therickmatos/Seguidor-de-linha/referencias/README.md

# Referências

## eva-rt/
Cópia do repositório [EXOTIC-TEAM-MX/EVA-RT](https://github.com/EXOTIC-TEAM-MX/EVA-RT) (commit `d630829`), sem a pasta `images/` (fotos grandes).
© EXOTIC TEAM MX, licença AGPL-3.0 (`eva-rt/LICENSE`).

- `3d_models/` — STL (carcaça e rotor da ventoinha, base de sucção, caixas de redução, aro, presilha, patim, suportes da bateria).
- `pcb_files/` — projeto EasyEDA Pro (`EVA_RT.eprj`, abre direto no EasyEDA Pro: footprints, posições e roteamento originais), Gerbers da placa principal e da barra VISION, PDFs de esquemático e PCB.
- `source_code/` — firmware 1.2.2 e LITE 1.0.
