therickmatos/Seguidor-de-linha/docs/DECISOES_2026-11-04.md

# Decisões de 03–04/11/2026 (depois do esquemático)

_Complementa `SEGUIDOR_JLC_DECISOES.md` e `ESQUEMATICO_SEGUIDOR.md`. Origem = centro da ventoinha, +y = frente, mm._

## Esquemático
- Feito em KiCad (rev 1.0), com todas as trocas: `hardware/seguidor_base/` (PDF, projeto, BOM, `REDES.md`).
- Conectividade conferida contra a netlist exportada: 54 redes, nenhuma fusão indevida, 7 pinos sem uso marcados.
- Gerado por script (`ferramentas/esquematico/gen.py`); footprints ainda não atribuídos (etapa da PCB).

## STL do EVA-RT × placa
- **Ordem: placa primeiro.** Os STL do EVA-RT são a referência fixa; a placa se ajusta a eles. A impressão leva horas; a placa, semanas.
- **Sem mudança:** gearbox, wheel_rim (692ZZ cabe), impeller_base_1/2, impeller_fan, suction_base, bead, battery_holder, barilla_clamp/barilla_connection. O contorno B mantém o furo Ø17 da ventoinha, os 4 furos da carcaça em (±15,56; ±15,56), os 4 dos suportes de motor em (±35,25; −3,73/−26,55) e as presilhas da vareta em (±43,75; −1,75/10,75).
- **Patim da barra:** usar o `sensor_sledge` refeito na v5 para os furos Ø2,05 da V1 (x = ±44,63, 89,25 mm entre furos; na VISION são ±44,0). Os furos Ø1,6 sem metalização em (±9,2; 0,55) são iguais na V1 e na VISION.
- **Distância barra–eixo L = 67–70 mm:** só cortar a vareta (~44 mm, uns 12 mm mais curta que a do EVA-RT).
- **Áreas proibidas no layout:**
  - embaixo: placa de sucção, x ±23,1, y −27,5…21;
  - em cima: pés da carcaça da ventoinha (impeller_base_1);
  - furos e caminho das presilhas da vareta.
- **Antes de pedir:** exportar o 3D da placa e montar com os STL para conferir colisões.
- Talvez rever o battery_holder depois de posicionar o conector de gravação (a bateria apoia ~2,5 mm nele).

## Barra de sensores
- **Fica a V1 de 12 sensores** (geometria da VISION do EVA-RT, firmware 1.2.2 como está). Erick já tem as barras; não entra no pedido.
- 16 sensores: só numa V2 futura, no mesmo conector. O firmware é parametrizado (`NUM_SENSORS`, `FIRST/LAST_SENSOR_SWITCH_CONFIG`); o `ADC_GND_CHANNEL` é o canal GND interno do ATmega, não do mux. Reajustar KP/KD.
- Corrente dos LEDs da barra: 2 QRE em série por 150 Ω (~17 mA por par) → ~104 mA com 12 sensores.

## Pedido JLC (cupom de US$ 50)
- Duas placas: **seguidor com os braços de marca integrados** + **perseguidor**.
- Terceira vaga: não precisa ocupar. Avaliado:
  - v5 de fenolite como plano B do seguidor: reduz risco de erro de projeto, mas tem 148 × 78 mm (passa de 100 × 100), ainda não está no EasyEDA e não protege contra atraso do frete;
  - placa de outro robô: agora não (rouba tempo do layout);
  - saldo para frete/imposto ou estêncil (só se soldar com pasta + ar quente/placa aquecedora; pesa no frete).
- **PCBA só pela cor preta não compensa:** a PCB sai em 24 h, mas a montagem SMT vem depois (24–48 h) e o valor declarado sobe. Se fizer PCBA, que seja dos dois DRV8874 (pad térmico).

## Nome do seguidor (não decidido)
- Favoritos: **AVE** (EVA ao contrário; "AVE · baseado no EVA-RT") e **SACI** (redemoinho = ventoinha centrífuga).
- Outros: ÍRIS, NOVA, CORISCO, SUCURI, COLIBRI, RISCO, FAÍSCA, VÁCUO, VEGA, KIDDO, 88, AUTOBAHN.
- Conferir se nenhuma equipe do TRIF/RoboCore já usa.

## Próximos passos
1. Layout da placa base no EasyEDA Pro: contorno B (`hardware/contorno/`), esquemático KiCad como referência, áreas dos STL, DRV8874 com vias no pad térmico.
2. Placa do perseguidor.
3. 3D da placa × STL; Gerber; pedido na JLC.
4. Firmware EVA-RT 1.2.2 (mapa de pinos igual).

## Fora deste pacote
- `EVA-RT_B_degraus_referencia.dxf` e `marcas_sim.py` (feitos em outra conversa).
- Arquivos da fenolite v3/v4/v5 (repositório `therickmatos/seguidor-fenolite`).
