therickmatos/Seguidor-de-linha/Estudo de caso - viabilidade do seguidor de linha/08_chassi_asa_de_gaivota/dados/tabelas.md

# Tabelas geradas por `codigo/verificar.py`

Margem = quanto o centro do QRE entra na fita, na pior marca (mm; negativo = não passa). "Comum" = mesma conta na região que vale para qualquer fita dentro da tolerância do regulamento (±1 mm na linha, ±3 mm na marca).

## TRIF 2025

| Configuração | Cenário | Marcas (esq. / dir.) | Região comum | Margem mín. | Margem comum | Pior marca | Folga até a linha (int. / ext.) |
|---|---|---:|---:|---:|---:|---|---|
| Asa de gaivota · 63,14 mm | ideal | 33/33 (31/31 · 2/2) | 33/33 | 5.5 | 0.9 | C30 | 1.9 / 32.8 |
| Asa de gaivota · 63,14 mm | desvio -3 mm | 33/33 (31/31 · 2/2) | 33/33 | 5.0 | 0.5 | Partida | 5.5 / 36.4 |
| Asa de gaivota · 63,14 mm | desvio +3 mm | 33/33 (31/31 · 2/2) | 30/33 | 3.2 | -2.0 | C06 | -1.7 / 29.2 |
| Asa de gaivota · 63,14 mm | desvio -5 mm | 33/33 (31/31 · 2/2) | 33/33 | 3.6 | 0.6 | C14 | 3.5 / 34.5 |
| Asa de gaivota · 63,14 mm | desvio +5 mm | 33/33 (31/31 · 2/2) | 30/33 | 1.4 | -3.8 | C06 | -4.1 / 26.8 |
| Asa de gaivota · 63,14 mm | abre 10 mm | 33/33 (31/31 · 2/2) | 33/33 | 5.5 | 0.4 | C25 | 8.6 / 39.5 |
| Asa de gaivota · 63,14 mm | abre 20 mm | 33/33 (31/31 · 2/2) | 33/33 | 5.6 | 0.7 | C07 | 15.3 / 46.2 |
| Asa de gaivota · 63,14 mm | abre 30 mm | 33/33 (31/31 · 2/2) | 33/33 | 5.6 | 0.4 | C13 | 21.2 / 52.3 |
| Asa de gaivota · 65 mm | ideal | 33/33 (31/31 · 2/2) | 32/33 | 5.1 | -0.1 | C06 | 0.7 / 31.6 |
| Asa de gaivota · 65 mm | desvio -3 mm | 33/33 (31/31 · 2/2) | 33/33 | 4.9 | 0.5 | C14 | 4.3 / 35.2 |
| Asa de gaivota · 65 mm | desvio +3 mm | 33/33 (31/31 · 2/2) | 30/33 | 2.3 | -2.9 | C06 | -2.9 / 28.0 |
| Asa de gaivota · 65 mm | desvio -5 mm | 33/33 (31/31 · 2/2) | 33/33 | 3.0 | -0.0 | C14 | 2.5 / 33.5 |
| Asa de gaivota · 65 mm | desvio +5 mm | 33/33 (31/31 · 2/2) | 30/33 | 0.4 | -4.8 | C06 | -5.3 / 25.6 |
| Asa de gaivota · 65 mm | abre 10 mm | 33/33 (31/31 · 2/2) | 33/33 | 5.4 | 0.3 | C01 | 7.3 / 38.2 |
| Asa de gaivota · 65 mm | abre 20 mm | 33/33 (31/31 · 2/2) | 33/33 | 5.8 | 0.8 | C07 | 14.0 / 44.9 |
| Asa de gaivota · 65 mm | abre 30 mm | 33/33 (31/31 · 2/2) | 33/33 | 5.6 | 0.6 | C13 | 20.2 / 51.2 |
| Asa de gaivota · 61 mm (referência) | ideal | 33/33 (31/31 · 2/2) | 33/33 | 5.4 | 0.9 | C03 | 3.3 / 34.2 |
| Asa de gaivota · 61 mm (referência) | desvio -3 mm | 33/33 (31/31 · 2/2) | 33/33 | 5.0 | 0.5 | Partida | 6.9 / 37.7 |
| Asa de gaivota · 61 mm (referência) | desvio +3 mm | 33/33 (31/31 · 2/2) | 30/33 | 4.4 | -0.9 | C06 | -0.3 / 30.6 |
| Asa de gaivota · 61 mm (referência) | desvio -5 mm | 33/33 (31/31 · 2/2) | 33/33 | 4.4 | 1.4 | C14 | 4.6 / 35.6 |
| Asa de gaivota · 61 mm (referência) | desvio +5 mm | 33/33 (31/31 · 2/2) | 30/33 | 2.5 | -2.7 | C06 | -2.7 / 28.1 |
| Asa de gaivota · 61 mm (referência) | abre 10 mm | 33/33 (31/31 · 2/2) | 33/33 | 5.2 | 0.5 | C25 | 10.0 / 40.9 |
| Asa de gaivota · 61 mm (referência) | abre 20 mm | 33/33 (31/31 · 2/2) | 33/33 | 5.8 | 0.7 | C05 | 16.7 / 47.6 |
| Asa de gaivota · 61 mm (referência) | abre 30 mm | 33/33 (31/31 · 2/2) | 33/33 | 5.6 | 0.5 | C13 | 22.4 / 53.5 |
| Asa anterior, externo (82; 20) · 63,14 mm | ideal | 33/33 (31/31 · 2/2) | 33/33 | 5.2 | 0.9 | C30 | 1.9 / 34.0 |
| Asa anterior, externo (82; 20) · 63,14 mm | desvio -3 mm | 33/33 (31/31 · 2/2) | 33/33 | 4.5 | 0.5 | Partida | 5.5 / 37.6 |
| Asa anterior, externo (82; 20) · 63,14 mm | desvio +3 mm | 33/33 (31/31 · 2/2) | 30/33 | 3.2 | -2.0 | C06 | -1.7 / 30.4 |
| Asa anterior, externo (82; 20) · 63,14 mm | desvio -5 mm | 33/33 (31/31 · 2/2) | 33/33 | 4.4 | 1.1 | C14 | 3.5 / 35.6 |
| Asa anterior, externo (82; 20) · 63,14 mm | desvio +5 mm | 33/33 (31/31 · 2/2) | 30/33 | 1.4 | -3.8 | C06 | -4.1 / 27.9 |
| Asa anterior, externo (82; 20) · 63,14 mm | abre 10 mm | 33/33 (31/31 · 2/2) | 33/33 | 5.5 | 0.1 | C01 | 8.6 / 40.7 |
| Asa anterior, externo (82; 20) · 63,14 mm | abre 20 mm | 33/33 (31/31 · 2/2) | 33/33 | 5.6 | 0.5 | C13 | 15.3 / 47.3 |
| Asa anterior, externo (82; 20) · 63,14 mm | abre 30 mm | 33/33 (31/31 · 2/2) | 33/33 | 5.3 | 0.4 | C10 | 21.2 / 53.2 |
| Chassi baixo (esboço) · 63,14 mm | ideal | 33/33 (31/31 · 2/2) | 33/33 | 5.4 | 1.6 | C14 | 4.8 / 29.8 |
| Chassi baixo (esboço) · 63,14 mm | desvio -3 mm | 33/33 (31/31 · 2/2) | 32/33 | 2.7 | -0.4 | C14 | 8.4 / 33.4 |
| Chassi baixo (esboço) · 63,14 mm | desvio +3 mm | 33/33 (31/31 · 2/2) | 30/33 | 4.3 | -1.3 | C06 | 1.2 / 26.2 |
| Chassi baixo (esboço) · 63,14 mm | desvio -5 mm | 33/33 (31/31 · 2/2) | 32/33 | 0.8 | -2.2 | C14 | 6.2 / 31.4 |
| Chassi baixo (esboço) · 63,14 mm | desvio +5 mm | 33/33 (31/31 · 2/2) | 30/33 | 2.4 | -3.2 | C06 | -1.2 / 23.8 |
| Chassi baixo (esboço) · 63,14 mm | abre 10 mm | 33/33 (31/31 · 2/2) | 33/33 | 7.9 | 3.4 | C17 | 11.5 / 36.5 |
| Chassi baixo (esboço) · 63,14 mm | abre 20 mm | 33/33 (31/31 · 2/2) | 33/33 | 8.9 | 3.6 | C31 | 18.1 / 43.1 |
| Chassi baixo (esboço) · 63,14 mm | abre 30 mm | 33/33 (31/31 · 2/2) | 33/33 | 7.6 | 3.3 | C13 | 23.6 / 49.0 |
| v3 atual · 63,14 mm | ideal | 24/33 (22/31 · 2/2) | 16/33 | -10.9 | -16.0 | C06 | 19.3 |
| v3 atual · 63,14 mm | desvio -3 mm | 24/33 (22/31 · 2/2) | 21/33 | -8.1 | -13.2 | C06 | 22.9 |
| v3 atual · 63,14 mm | desvio +3 mm | 22/33 (20/31 · 2/2) | 15/33 | -13.7 | -18.8 | C06 | 15.7 |
| v3 atual · 63,14 mm | desvio -5 mm | 27/33 (25/31 · 2/2) | 22/33 | -7.2 | -11.4 | C14 | 21.3 |
| v3 atual · 63,14 mm | desvio +5 mm | 19/33 (17/31 · 2/2) | 15/33 | -15.6 | -20.7 | C06 | 13.3 |
| v3 atual · 63,14 mm | abre 10 mm | 28/33 (26/31 · 2/2) | 21/33 | -6.7 | -12.0 | C06 | 26.0 |
| v3 atual · 63,14 mm | abre 20 mm | 33/33 (31/31 · 2/2) | 24/33 | 1.4 | -4.4 | C08 | 32.7 |
| v3 atual · 63,14 mm | abre 30 mm | 33/33 (31/31 · 2/2) | 31/33 | 3.0 | -2.2 | C08 | 39.5 |

## TRIF 2024

| Configuração | Cenário | Marcas (esq. / dir.) | Região comum | Margem mín. | Margem comum | Pior marca | Folga até a linha (int. / ext.) |
|---|---|---:|---:|---:|---:|---|---|
| Asa de gaivota · 63,14 mm | ideal | 35/35 (33/33 · 2/2) | 35/35 | 5.9 | 1.2 | C27 | 3.5 / 34.3 |
| Asa de gaivota · 63,14 mm | desvio -3 mm | 35/35 (33/33 · 2/2) | 35/35 | 3.0 | 0.0 | C27 | -0.3 / 30.5 |
| Asa de gaivota · 63,14 mm | desvio +3 mm | 35/35 (33/33 · 2/2) | 35/35 | 5.4 | 2.2 | C30 | 5.4 / 36.3 |
| Asa de gaivota · 63,14 mm | desvio -5 mm | 35/35 (33/33 · 2/2) | 34/35 | 1.1 | -1.9 | C27 | -2.9 / 27.9 |
| Asa de gaivota · 63,14 mm | desvio +5 mm | 35/35 (33/33 · 2/2) | 35/35 | 7.1 | 1.8 | C06 | 3.1 / 34.0 |
| Asa de gaivota · 63,14 mm | abre 10 mm | 35/35 (33/33 · 2/2) | 35/35 | 7.3 | 1.5 | C11 | 10.8 / 41.6 |
| Asa de gaivota · 63,14 mm | abre 20 mm | 35/35 (33/33 · 2/2) | 35/35 | 6.0 | 1.4 | C21 | 17.4 / 48.3 |
| Asa de gaivota · 63,14 mm | abre 30 mm | 35/35 (33/33 · 2/2) | 35/35 | 5.8 | 0.5 | C31 | 22.0 / 53.0 |
| Asa de gaivota · 65 mm | ideal | 35/35 (33/33 · 2/2) | 35/35 | 5.0 | 1.2 | C27 | 2.1 / 32.9 |
| Asa de gaivota · 65 mm | desvio -3 mm | 35/35 (33/33 · 2/2) | 34/35 | 2.1 | -0.8 | C27 | -1.8 / 29.0 |
| Asa de gaivota · 65 mm | desvio +3 mm | 35/35 (33/33 · 2/2) | 35/35 | 5.4 | 2.2 | C30 | 4.3 / 35.2 |
| Asa de gaivota · 65 mm | desvio -5 mm | 35/35 (33/33 · 2/2) | 33/35 | 0.2 | -2.8 | C27 | -4.3 / 26.5 |
| Asa de gaivota · 65 mm | desvio +5 mm | 35/35 (33/33 · 2/2) | 35/35 | 6.2 | 0.9 | C06 | 2.0 / 32.9 |
| Asa de gaivota · 65 mm | abre 10 mm | 35/35 (33/33 · 2/2) | 35/35 | 7.7 | 1.5 | C11 | 9.3 / 40.2 |
| Asa de gaivota · 65 mm | abre 20 mm | 35/35 (33/33 · 2/2) | 35/35 | 5.6 | 1.5 | C21 | 16.0 / 46.9 |
| Asa de gaivota · 65 mm | abre 30 mm | 35/35 (33/33 · 2/2) | 35/35 | 6.1 | 0.7 | C31 | 20.9 / 52.0 |
| Asa de gaivota · 61 mm (referência) | ideal | 35/35 (33/33 · 2/2) | 35/35 | 6.8 | 1.1 | C27 | 5.1 / 35.9 |
| Asa de gaivota · 61 mm (referência) | desvio -3 mm | 35/35 (33/33 · 2/2) | 35/35 | 3.9 | 0.5 | C27 | 1.4 / 32.2 |
| Asa de gaivota · 61 mm (referência) | desvio +3 mm | 35/35 (33/33 · 2/2) | 35/35 | 5.4 | 2.2 | C30 | 6.7 / 37.6 |
| Asa de gaivota · 61 mm (referência) | desvio -5 mm | 35/35 (33/33 · 2/2) | 34/35 | 2.0 | -0.9 | C27 | -1.2 / 29.6 |
| Asa de gaivota · 61 mm (referência) | desvio +5 mm | 35/35 (33/33 · 2/2) | 35/35 | 7.2 | 2.7 | C25 | 4.4 / 35.3 |
| Asa de gaivota · 61 mm (referência) | abre 10 mm | 35/35 (33/33 · 2/2) | 35/35 | 6.9 | 1.5 | C32 | 12.4 / 43.2 |
| Asa de gaivota · 61 mm (referência) | abre 20 mm | 35/35 (33/33 · 2/2) | 35/35 | 5.5 | 1.2 | C05 | 18.9 / 49.8 |
| Asa de gaivota · 61 mm (referência) | abre 30 mm | 35/35 (33/33 · 2/2) | 35/35 | 5.4 | 0.4 | C31 | 23.1 / 54.2 |
| Asa anterior, externo (82; 20) · 63,14 mm | ideal | 35/35 (33/33 · 2/2) | 35/35 | 6.7 | 0.8 | C27 | 3.5 / 35.6 |
| Asa anterior, externo (82; 20) · 63,14 mm | desvio -3 mm | 35/35 (33/33 · 2/2) | 35/35 | 3.7 | 0.5 | C27 | -0.3 / 31.8 |
| Asa anterior, externo (82; 20) · 63,14 mm | desvio +3 mm | 35/35 (33/33 · 2/2) | 35/35 | 5.4 | 2.2 | C30 | 5.4 / 37.5 |
| Asa anterior, externo (82; 20) · 63,14 mm | desvio -5 mm | 35/35 (33/33 · 2/2) | 34/35 | 1.8 | -1.1 | C27 | -2.9 / 29.2 |
| Asa anterior, externo (82; 20) · 63,14 mm | desvio +5 mm | 35/35 (33/33 · 2/2) | 35/35 | 7.1 | 1.8 | C25 | 3.1 / 35.1 |
| Asa anterior, externo (82; 20) · 63,14 mm | abre 10 mm | 35/35 (33/33 · 2/2) | 35/35 | 7.3 | 1.0 | C11 | 10.8 / 42.8 |
| Asa anterior, externo (82; 20) · 63,14 mm | abre 20 mm | 35/35 (33/33 · 2/2) | 35/35 | 6.0 | 1.0 | C05 | 17.4 / 49.4 |
| Asa anterior, externo (82; 20) · 63,14 mm | abre 30 mm | 35/35 (33/33 · 2/2) | 35/35 | 5.5 | 0.2 | C28 | 22.0 / 53.9 |
| Chassi baixo (esboço) · 63,14 mm | ideal | 35/35 (33/33 · 2/2) | 35/35 | 3.1 | 0.2 | C27 | 6.5 / 31.4 |
| Chassi baixo (esboço) · 63,14 mm | desvio -3 mm | 35/35 (33/33 · 2/2) | 33/35 | 0.2 | -2.7 | C27 | 2.7 / 27.6 |
| Chassi baixo (esboço) · 63,14 mm | desvio +3 mm | 35/35 (33/33 · 2/2) | 35/35 | 6.0 | 3.0 | C27 | 8.2 / 33.3 |
| Chassi baixo (esboço) · 63,14 mm | desvio -5 mm | 34/35 (32/33 · 2/2) | 31/35 | -1.7 | -4.7 | C27 | 0.2 / 25.0 |
| Chassi baixo (esboço) · 63,14 mm | desvio +5 mm | 35/35 (33/33 · 2/2) | 35/35 | 7.0 | 1.6 | C06 | 5.9 / 31.0 |
| Chassi baixo (esboço) · 63,14 mm | abre 10 mm | 35/35 (33/33 · 2/2) | 35/35 | 6.3 | 3.3 | C27 | 13.7 / 38.6 |
| Chassi baixo (esboço) · 63,14 mm | abre 20 mm | 35/35 (33/33 · 2/2) | 35/35 | 8.3 | 3.6 | C31 | 20.2 / 45.2 |
| Chassi baixo (esboço) · 63,14 mm | abre 30 mm | 35/35 (33/33 · 2/2) | 35/35 | 7.5 | 3.4 | C31 | 24.3 / 49.7 |
| v3 atual · 63,14 mm | ideal | 20/35 (18/33 · 2/2) | 19/35 | -5.0 | -10.1 | C06 | 20.7 |
| v3 atual · 63,14 mm | desvio -3 mm | 21/35 (19/33 · 2/2) | 19/35 | -7.8 | -10.7 | C27 | 16.8 |
| v3 atual · 63,14 mm | desvio +3 mm | 21/35 (19/33 · 2/2) | 16/35 | -7.6 | -12.9 | C06 | 23.0 |
| v3 atual · 63,14 mm | desvio -5 mm | 26/35 (24/33 · 2/2) | 19/35 | -9.7 | -12.7 | C27 | 14.3 |
| v3 atual · 63,14 mm | desvio +5 mm | 22/35 (20/33 · 2/2) | 8/35 | -9.5 | -14.7 | C06 | 20.6 |
| v3 atual · 63,14 mm | abre 10 mm | 23/35 (21/33 · 2/2) | 19/35 | -2.2 | -7.7 | C06 | 28.0 |
| v3 atual · 63,14 mm | abre 20 mm | 35/35 (33/33 · 2/2) | 21/35 | 0.4 | -5.4 | C06 | 34.8 |
| v3 atual · 63,14 mm | abre 30 mm | 35/35 (33/33 · 2/2) | 23/35 | 3.5 | -2.3 | C24 | 40.2 |

## EVA-RT teste

| Configuração | Cenário | Marcas (esq. / dir.) | Região comum | Margem mín. | Margem comum | Pior marca | Folga até a linha (int. / ext.) |
|---|---|---:|---:|---:|---:|---|---|
| Asa de gaivota · 63,14 mm | ideal | 25/26 (23/24 · 2/2) | 23/26 | -4.9 | -7.7 | C12 | -9.5 / -1.0 |
| Asa de gaivota · 63,14 mm | desvio -3 mm | 25/26 (23/24 · 2/2) | 23/26 | -8.1 | -10.9 | C12 | -9.5 / 1.9 |
| Asa de gaivota · 63,14 mm | desvio +3 mm | 25/26 (23/24 · 2/2) | 23/26 | -1.7 | -4.5 | C12 | -9.5 / -7.8 |
| Asa de gaivota · 63,14 mm | desvio -5 mm | 25/26 (23/24 · 2/2) | 24/26 | -10.3 | -13.1 | C12 | -9.5 / -1.9 |
| Asa de gaivota · 63,14 mm | desvio +5 mm | 26/26 (24/24 · 2/2) | 23/26 | 0.4 | -4.5 | C12 | -9.5 / -9.5 |
| Asa de gaivota · 63,14 mm | abre 10 mm | 26/26 (24/24 · 2/2) | 25/26 | 0.0 | -2.8 | C12 | -9.5 / 3.1 |
| Asa de gaivota · 63,14 mm | abre 20 mm | 26/26 (24/24 · 2/2) | 26/26 | 5.2 | 1.2 | C07 | 0.9 / 1.6 |
| Asa de gaivota · 63,14 mm | abre 30 mm | 26/26 (24/24 · 2/2) | 26/26 | 7.7 | 1.6 | C06 | 10.2 / -0.7 |
| Asa de gaivota · 65 mm | ideal | 25/26 (23/24 · 2/2) | 23/26 | -6.0 | -8.8 | C12 | -9.5 / -4.6 |
| Asa de gaivota · 65 mm | desvio -3 mm | 25/26 (23/24 · 2/2) | 23/26 | -9.3 | -12.1 | C12 | -9.5 / -0.7 |
| Asa de gaivota · 65 mm | desvio +3 mm | 25/26 (23/24 · 2/2) | 23/26 | -2.8 | -5.6 | C12 | -9.5 / -9.4 |
| Asa de gaivota · 65 mm | desvio -5 mm | 24/26 (22/24 · 2/2) | 24/26 | -11.4 | -14.2 | C12 | -9.5 / -4.6 |
| Asa de gaivota · 65 mm | desvio +5 mm | 24/26 (22/24 · 2/2) | 21/26 | -0.7 | -5.4 | C12 | -9.5 / -9.4 |
| Asa de gaivota · 65 mm | abre 10 mm | 25/26 (23/24 · 2/2) | 25/26 | -1.1 | -4.0 | C12 | -9.5 / 2.6 |
| Asa de gaivota · 65 mm | abre 20 mm | 26/26 (24/24 · 2/2) | 26/26 | 4.3 | 1.3 | C12 | -1.5 / 1.2 |
| Asa de gaivota · 65 mm | abre 30 mm | 26/26 (24/24 · 2/2) | 26/26 | 7.4 | 1.4 | C07 | 8.1 / -0.9 |
| Asa de gaivota · 61 mm (referência) | ideal | 25/26 (23/24 · 2/2) | 24/26 | -3.6 | -6.4 | C12 | -9.5 / 2.9 |
| Asa de gaivota · 61 mm (referência) | desvio -3 mm | 25/26 (23/24 · 2/2) | 24/26 | -6.8 | -9.6 | C12 | -9.5 / 4.7 |
| Asa de gaivota · 61 mm (referência) | desvio +3 mm | 25/26 (23/24 · 2/2) | 23/26 | -0.4 | -3.4 | C12 | -9.5 / -3.6 |
| Asa de gaivota · 61 mm (referência) | desvio -5 mm | 25/26 (23/24 · 2/2) | 24/26 | -8.9 | -11.7 | C12 | -9.5 / 1.1 |
| Asa de gaivota · 61 mm (referência) | desvio +5 mm | 26/26 (24/24 · 2/2) | 23/26 | 1.7 | -3.6 | C12 | -9.5 / -8.1 |
| Asa de gaivota · 61 mm (referência) | abre 10 mm | 26/26 (24/24 · 2/2) | 25/26 | 1.4 | -1.4 | C12 | -9.5 / 3.7 |
| Asa de gaivota · 61 mm (referência) | abre 20 mm | 26/26 (24/24 · 2/2) | 26/26 | 5.5 | 1.5 | C07 | 3.6 / 2.0 |
| Asa de gaivota · 61 mm (referência) | abre 30 mm | 26/26 (24/24 · 2/2) | 26/26 | 7.3 | 1.6 | C06 | 12.6 / -0.5 |
| Asa anterior, externo (82; 20) · 63,14 mm | ideal | 25/26 (23/24 · 2/2) | 24/26 | -4.1 | -6.8 | C12 | -9.5 / 0.7 |
| Asa anterior, externo (82; 20) · 63,14 mm | desvio -3 mm | 25/26 (23/24 · 2/2) | 23/26 | -7.3 | -10.1 | C12 | -9.5 / 3.0 |
| Asa anterior, externo (82; 20) · 63,14 mm | desvio +3 mm | 25/26 (23/24 · 2/2) | 24/26 | -0.9 | -3.7 | C12 | -9.5 / -6.1 |
| Asa anterior, externo (82; 20) · 63,14 mm | desvio -5 mm | 25/26 (23/24 · 2/2) | 24/26 | -9.5 | -12.2 | C12 | -9.5 / -0.4 |
| Asa anterior, externo (82; 20) · 63,14 mm | desvio +5 mm | 26/26 (24/24 · 2/2) | 24/26 | 1.2 | -1.5 | C12 | -9.5 / -9.4 |
| Asa anterior, externo (82; 20) · 63,14 mm | abre 10 mm | 26/26 (24/24 · 2/2) | 25/26 | 0.9 | -2.0 | C12 | -9.5 / 2.2 |
| Asa anterior, externo (82; 20) · 63,14 mm | abre 20 mm | 26/26 (24/24 · 2/2) | 26/26 | 5.2 | 1.1 | C07 | 0.9 / 0.5 |
| Asa anterior, externo (82; 20) · 63,14 mm | abre 30 mm | 26/26 (24/24 · 2/2) | 26/26 | 7.6 | 1.1 | Partida | 10.2 / -1.8 |
| Chassi baixo (esboço) · 63,14 mm | ideal | 25/26 (23/24 · 2/2) | 24/26 | -7.4 | -10.2 | C12 | -9.5 / -3.4 |
| Chassi baixo (esboço) · 63,14 mm | desvio -3 mm | 24/26 (22/24 · 2/2) | 24/26 | -10.7 | -13.4 | C12 | -9.5 / -0.7 |
| Chassi baixo (esboço) · 63,14 mm | desvio +3 mm | 25/26 (23/24 · 2/2) | 25/26 | -4.2 | -7.0 | C12 | -9.5 / -9.5 |
| Chassi baixo (esboço) · 63,14 mm | desvio -5 mm | 24/26 (22/24 · 2/2) | 24/26 | -12.8 | -15.6 | C12 | -9.5 / -4.5 |
| Chassi baixo (esboço) · 63,14 mm | desvio +5 mm | 25/26 (23/24 · 2/2) | 24/26 | -2.1 | -4.9 | C12 | -9.5 / -9.5 |
| Chassi baixo (esboço) · 63,14 mm | abre 10 mm | 25/26 (23/24 · 2/2) | 25/26 | -2.6 | -5.4 | C12 | -9.5 / 6.4 |
| Chassi baixo (esboço) · 63,14 mm | abre 20 mm | 26/26 (24/24 · 2/2) | 25/26 | 2.8 | -0.2 | C12 | 3.9 / 4.7 |
| Chassi baixo (esboço) · 63,14 mm | abre 30 mm | 26/26 (24/24 · 2/2) | 26/26 | 8.6 | 5.2 | C12 | 12.9 / 2.4 |
| v3 atual · 63,14 mm | ideal | 20/26 (18/24 · 2/2) | 15/26 | -15.3 | -18.1 | C12 | -9.5 |
| v3 atual · 63,14 mm | desvio -3 mm | 21/26 (19/24 · 2/2) | 16/26 | -18.5 | -21.3 | C12 | -9.5 |
| v3 atual · 63,14 mm | desvio +3 mm | 16/26 (14/24 · 2/2) | 12/26 | -12.1 | -17.0 | C12 | -9.5 |
| v3 atual · 63,14 mm | desvio -5 mm | 21/26 (19/24 · 2/2) | 19/26 | -20.7 | -23.5 | C12 | -9.5 |
| v3 atual · 63,14 mm | desvio +5 mm | 14/26 (13/24 · 1/2) | 11/26 | -10.9 | -17.4 | C24 | -9.5 |
| v3 atual · 63,14 mm | abre 10 mm | 23/26 (21/24 · 2/2) | 19/26 | -10.5 | -13.4 | C12 | 2.6 |
| v3 atual · 63,14 mm | abre 20 mm | 25/26 (23/24 · 2/2) | 20/26 | -5.3 | -8.3 | C12 | 14.9 |
| v3 atual · 63,14 mm | abre 30 mm | 26/26 (24/24 · 2/2) | 24/26 | 0.3 | -2.7 | C12 | 12.8 |

## Curvas isoladas entre retas: folga até a borda da linha (mm), pior dos dois lados

Sensores na ordem interno / externo. Negativo = o centro do sensor passa sobre a linha principal.

| Configuração | R100 90° | R100 180° | R120 90° | R120 180° | R150 90° | R150 180° |
|---|---:|---:|---:|---:|---:|---:|
| Asa de gaivota · 63,14 mm | 1.5 / 32.4 | -9.5 / 11.2 | 5.2 / 36.1 | -8.6 / 22.0 | 9.9 / 40.8 | 2.4 / 33.2 |
| Asa de gaivota · 65 mm | 0.4 / 31.3 | -9.5 / 8.9 | 4.1 / 35.0 | -9.4 / 20.1 | 8.9 / 39.8 | 0.8 / 31.6 |
| Asa de gaivota · 61 mm (referência) | 2.8 / 33.7 | -9.4 / 13.8 | 6.4 / 37.3 | -6.4 / 24.2 | 11.0 / 42.0 | 4.2 / 34.9 |
| Asa anterior, externo (82; 20) · 63,14 mm | 1.5 / 33.6 | -9.5 / 12.6 | 5.2 / 37.3 | -8.6 / 23.4 | 9.9 / 42.0 | 2.4 / 34.5 |
| Chassi baixo (esboço) · 63,14 mm | 4.4 / 29.4 | -9.4 / 8.6 | 8.0 / 33.1 | -5.3 / 19.3 | 12.6 / 37.8 | 5.5 / 30.3 |
| v3 atual · 63,14 mm | 18.9 | -3.0 | 22.7 | 8.1 | 27.5 | 19.5 |
