therickmatos/Seguidor-de-linha/Estudo de caso - viabilidade do seguidor de linha/08_chassi_asa_de_gaivota/dados/escolha.md

# Escolha das posições (gerado por `codigo/escolher.py`)

Pior margem (mm) sobre as marcas do TRIF 2024 e 2025, 63,14 e 65 mm entre furos.
Célula: ideal+abre / com ±3 mm / região comum (ideal+abre). Linhas: sensor interno; colunas: externo.

| Interno (x; y) | externo (80; 14) | externo (80; 20) | externo (82; 14) | externo (82; 20) |
|---|---|---|---|---|
| (50; 4) | 3.1 / 0.4 / -1.8 | 3.1 / 0.4 / -1.8 | 3.1 / 0.4 / -1.8 | 3.1 / 0.4 / -1.8 |
| (50; 8) | 3.6 / 0.7 / -1.1 | 3.9 / 1.1 / -1.1 | 3.9 / 1.1 / -1.1 | 3.9 / 1.1 / -1.1 |
| (50; 12) | 3.6 / 0.7 / -0.2 | 4.0 / 1.2 / -0.2 | 4.8 / 2.1 / -0.2 | 4.8 / 2.1 / -0.4 |
| (50; 14) | 3.6 / 0.7 / 0.2 | 4.0 / 1.2 / 0.2 | 4.8 / 2.4 / -0.2 | 5.1 / 2.6 / -0.3 |
| (50; 16) | 3.6 / 0.7 / 0.6 | 4.0 / 1.2 / 0.8 | 4.8 / 2.4 / -0.2 | 4.9 / 2.8 / -0.1 |
| (50; 20) | 3.6 / 0.7 / 0.6 | 4.0 / 1.2 / 0.9 | 4.5 / 2.4 / -0.2 | 4.7 / 2.8 / 0.0 |
| (50.5; 4) | 2.7 / -0.0 / -2.2 | 2.7 / -0.0 / -2.2 | 2.7 / -0.0 / -2.2 | 2.7 / -0.0 / -2.2 |
| (50.5; 8) | 3.5 / 0.7 / -1.5 | 3.5 / 0.7 / -1.5 | 3.5 / 0.7 / -1.5 | 3.5 / 0.7 / -1.5 |
| (50.5; 12) | 3.6 / 0.7 / -0.6 | 4.0 / 1.2 / -0.6 | 4.4 / 1.7 / -0.6 | 4.4 / 1.7 / -0.6 |
| (50.5; 14) | 3.6 / 0.7 / -0.1 | 4.0 / 1.2 / -0.1 | 4.8 / 2.3 / -0.1 | 5.1 / 2.3 / -0.1 |
| (50.5; 16) | 3.6 / 0.7 / 0.5 | 4.0 / 1.2 / 0.5 | 4.8 / 2.4 / -0.1 | 5.1 / 2.8 / 0.0 |
| (50.5; 20) | 3.6 / 0.7 / 0.6 | 4.0 / 1.2 / 0.9 | 4.7 / 2.4 / -0.2 | 5.0 / 2.8 / 0.0 |
| (52; 4) | 1.6 / -1.2 / -3.3 | 1.6 / -1.2 / -3.3 | 1.6 / -1.2 / -3.3 | 1.6 / -1.2 / -3.3 |
| (52; 8) | 2.4 / -0.4 / -2.7 | 2.4 / -0.4 / -2.7 | 2.4 / -0.4 / -2.7 | 2.4 / -0.4 / -2.7 |
| (52; 12) | 3.3 / 0.5 / -1.8 | 3.3 / 0.5 / -1.8 | 3.3 / 0.5 / -1.8 | 3.3 / 0.5 / -1.8 |
| (52; 14) | 3.6 / 0.7 / -1.3 | 3.9 / 1.1 / -1.3 | 3.9 / 1.1 / -1.3 | 3.9 / 1.1 / -1.3 |
| (52; 16) | 3.6 / 0.7 / -0.7 | 4.0 / 1.2 / -0.7 | 4.6 / 1.8 / -0.7 | 4.6 / 1.8 / -0.7 |
| (52; 20) | 3.6 / 0.7 / 0.6 | 4.0 / 1.2 / 0.7 | 5.2 / 2.4 / 0.6 | 5.4 / 2.8 / 0.7 |
| (55; 4) | -0.7 / -3.4 / -5.6 | -0.7 / -3.4 / -5.6 | -0.7 / -3.4 / -5.6 | -0.7 / -3.4 / -5.6 |
| (55; 8) | 0.1 / -2.7 / -5.0 | 0.1 / -2.7 / -5.0 | 0.1 / -2.7 / -5.0 | 0.1 / -2.7 / -5.0 |
| (55; 12) | 1.1 / -1.7 / -4.1 | 1.1 / -1.7 / -4.1 | 1.1 / -1.7 / -4.1 | 1.1 / -1.7 / -4.1 |
| (55; 14) | 1.7 / -1.1 / -3.6 | 1.7 / -1.1 / -3.6 | 1.7 / -1.1 / -3.6 | 1.7 / -1.1 / -3.6 |
| (55; 16) | 2.4 / -0.4 / -3.0 | 2.4 / -0.4 / -3.0 | 2.4 / -0.4 / -3.0 | 2.4 / -0.4 / -3.0 |
| (55; 20) | 3.6 / 0.7 / -1.5 | 4.0 / 1.2 / -1.5 | 4.1 / 1.2 / -1.5 | 4.1 / 1.2 / -1.5 |
