therickmatos/Seguidor-de-linha/Estudo de caso - viabilidade do seguidor de linha/07_firmware_e_geometria/dados/tabelas.md

### Configurações × pistas (um QRE por lado em X = ±69,5; Y = 4,5)

| Pista | Configuração | L | Furos* | Curva (esq.) | Região comum | Com ±5 mm de erro | Partida/chegada | Cruzamentos vetados | Parada do firmware |
|---|---|---:|---:|---:|---:|---:|---:|---:|---|
| TRIF 2025 | v3 · 63,14 mm entre furos | 107.1 | 63.1 | 22/31 | 14/31 | 19/31 | 2/2 | 2 (defasagem ≤ 0.2 mm) | na chegada |
| TRIF 2025 | EVA-RT original (L 100) | 100.0 | 56.0 | 24/31 | 19/31 | 23/31 | 2/2 | 2 (defasagem ≤ 0.2 mm) | na chegada |
| TRIF 2025 | v3 · L 85 | 85.0 | 41.0 | 28/31 | 23/31 | 28/31 | 2/2 | 2 (defasagem ≤ 0.0 mm) | na chegada |
| TRIF 2025 | v3 · L 80 | 80.0 | 36.0 | 31/31 | 28/31 | 28/31 | 2/2 | 2 (defasagem ≤ 0.0 mm) | na chegada |
| TRIF 2025 | v3 · L 70 | 70.0 | 26.0 | 31/31 | 31/31 | 31/31 | 2/2 | 2 (defasagem ≤ 0.0 mm) | na chegada |
| TRIF 2024 | v3 · 63,14 mm entre furos | 107.1 | 63.1 | 18/33 | 17/33 | 19/33 | 2/2 | 2 (defasagem ≤ 0.8 mm) | na chegada |
| TRIF 2024 | EVA-RT original (L 100) | 100.0 | 56.0 | 21/33 | 17/33 | 21/33 | 2/2 | 2 (defasagem ≤ 0.5 mm) | na chegada |
| TRIF 2024 | v3 · L 85 | 85.0 | 41.0 | 33/33 | 23/33 | 23/33 | 2/2 | 2 (defasagem ≤ 0.2 mm) | na chegada |
| TRIF 2024 | v3 · L 80 | 80.0 | 36.0 | 33/33 | 23/33 | 33/33 | 2/2 | 2 (defasagem ≤ 0.0 mm) | na chegada |
| TRIF 2024 | v3 · L 70 | 70.0 | 26.0 | 33/33 | 33/33 | 33/33 | 2/2 | 2 (defasagem ≤ 0.0 mm) | na chegada |
| EVA-RT teste | v3 · 63,14 mm entre furos | 107.1 | 63.1 | 18/24 | 13/24 | 13/24 | 2/2 | 6 (defasagem ≤ 55.4 mm) | FALSA (8×; a 1ª sobre «linha» a 3.5 m da partida) |
| EVA-RT teste | EVA-RT original (L 100) | 100.0 | 56.0 | 20/24 | 14/24 | 16/24 | 2/2 | 6 (defasagem ≤ 44.5 mm) | FALSA (5×; a 1ª sobre «linha» a 3.6 m da partida) |
| EVA-RT teste | v3 · L 85 | 85.0 | 41.0 | 23/24 | 20/24 | 22/24 | 2/2 | 6 (defasagem ≤ 29.0 mm) | na chegada |
| EVA-RT teste | v3 · L 80 | 80.0 | 36.0 | 23/24 | 22/24 | 22/24 | 2/2 | 6 (defasagem ≤ 25.0 mm) | na chegada |
| EVA-RT teste | v3 · L 70 | 70.0 | 26.0 | 24/24 | 24/24 | 24/24 | 2/2 | 6 (defasagem ≤ 19.0 mm) | na chegada |

\* distância entre o furo da frente da base (y = 10,75) e o furo da barra V1.

### Varredura, TRIF 2025: marcas de curva lidas (nominal / região comum) de 31

| L \ Y do sensor | 4.5 | 10 | 15 | 20 | 25 |
|---:|---:|---:|---:|---:|---:|
| 60 | 31 / 31 | 31 / 31 | 31 / 31 | 31 / 31 | 31 / 31 |
| 65 | 31 / 31 | 31 / 31 | 31 / 31 | 31 / 31 | 31 / 31 |
| 70 | 31 / 31 | 31 / 31 | 31 / 31 | 31 / 31 | 31 / 31 |
| 75 | 31 / 28 | 31 / 31 | 31 / 31 | 31 / 31 | 31 / 31 |
| 80 | 31 / 28 | 31 / 28 | 31 / 31 | 31 / 31 | 31 / 31 |
| 85 | 28 / 23 | 31 / 26 | 31 / 31 | 31 / 31 | 31 / 31 |
| 90 | 28 / 23 | 28 / 23 | 31 / 23 | 31 / 30 | 31 / 31 |
| 95 | 28 / 22 | 28 / 22 | 29 / 22 | 31 / 22 | 31 / 27 |
| 100 | 24 / 19 | 26 / 20 | 28 / 20 | 31 / 21 | 31 / 22 |
| 107.1 | 22 / 14 | 22 / 14 | 22 / 16 | 23 / 17 | 26 / 19 |

### Varredura, TRIF 2024: marcas de curva lidas (nominal / região comum) de 33

| L \ Y do sensor | 4.5 | 10 | 15 | 20 | 25 |
|---:|---:|---:|---:|---:|---:|
| 60 | 33 / 33 | 33 / 33 | 33 / 33 | 33 / 33 | 33 / 33 |
| 65 | 33 / 33 | 33 / 33 | 33 / 33 | 33 / 33 | 33 / 33 |
| 70 | 33 / 33 | 33 / 33 | 33 / 33 | 33 / 33 | 33 / 33 |
| 75 | 33 / 33 | 33 / 33 | 33 / 33 | 33 / 33 | 33 / 33 |
| 80 | 33 / 23 | 33 / 33 | 33 / 33 | 33 / 33 | 33 / 33 |
| 85 | 33 / 23 | 33 / 23 | 33 / 33 | 33 / 33 | 33 / 33 |
| 90 | 33 / 21 | 33 / 21 | 33 / 21 | 33 / 23 | 33 / 33 |
| 95 | 30 / 17 | 33 / 18 | 33 / 18 | 33 / 19 | 33 / 21 |
| 100 | 21 / 17 | 22 / 17 | 22 / 17 | 32 / 17 | 32 / 17 |
| 107.1 | 18 / 17 | 18 / 17 | 19 / 17 | 20 / 17 | 20 / 17 |

### Varredura, EVA-RT teste: marcas de curva lidas (nominal / região comum) de 24

| L \ Y do sensor | 4.5 | 10 | 15 | 20 | 25 |
|---:|---:|---:|---:|---:|---:|
| 60 | 24 / 24 | 24 / 24 | 24 / 24 | 24 / 24 | 24 / 24 |
| 65 | 24 / 24 | 24 / 24 | 24 / 24 | 24 / 24 | 24 / 24 |
| 70 | 24 / 24 | 24 / 24 | 24 / 24 | 24 / 24 | 24 / 24 |
| 75 | 24 / 23 | 24 / 23 | 24 / 24 | 24 / 24 | 24 / 24 |
| 80 | 23 / 22 | 24 / 23 | 24 / 23 | 24 / 23 | 24 / 23 |
| 85 | 23 / 20 | 23 / 22 | 23 / 22 | 23 / 22 | 23 / 23 |
| 90 | 21 / 19 | 23 / 21 | 23 / 22 | 23 / 22 | 23 / 22 |
| 95 | 21 / 17 | 22 / 19 | 22 / 20 | 22 / 22 | 22 / 22 |
| 100 | 20 / 14 | 21 / 18 | 22 / 19 | 22 / 20 | 22 / 20 |
| 107.1 | 18 / 13 | 21 / 14 | 22 / 15 | 22 / 19 | 22 / 20 |

### Sensibilidade a "abrir na curva" (centro da barra e mm para fora numa curva de raio 100)

Célula: marcas de curva lidas (nominal) · parada do firmware com janela de 30 mm.

| Pista | L | abre 0 mm | abre 10 mm | abre 20 mm | abre 30 mm |
|---|---:|---|---|---|---|
| TRIF 2025 | 107.1 | 22/31 · chegada | 26/31 · chegada | 31/31 · chegada | 31/31 · chegada |
| TRIF 2025 | 100 | 24/31 · chegada | 28/31 · chegada | 31/31 · chegada | 31/31 · chegada |
| TRIF 2025 | 85 | 28/31 · chegada | 31/31 · chegada | 31/31 · chegada | 31/31 · chegada |
| TRIF 2025 | 70 | 31/31 · chegada | 31/31 · chegada | 31/31 · chegada | 31/31 · chegada |
| TRIF 2024 | 107.1 | 18/33 · chegada | 21/33 · chegada | 33/33 · chegada | 33/33 · chegada |
| TRIF 2024 | 100 | 21/33 · chegada | 33/33 · chegada | 33/33 · chegada | 33/33 · chegada |
| TRIF 2024 | 85 | 33/33 · chegada | 33/33 · chegada | 33/33 · chegada | 33/33 · chegada |
| TRIF 2024 | 70 | 33/33 · chegada | 33/33 · chegada | 33/33 · chegada | 33/33 · chegada |
| EVA-RT teste | 107.1 | 18/24 · FALSA (8×) | 21/24 · FALSA (3×) | 23/24 · chegada | 24/24 · chegada |
| EVA-RT teste | 100 | 20/24 · FALSA (5×) | 21/24 · FALSA (1×) | 23/24 · chegada | 24/24 · chegada |
| EVA-RT teste | 85 | 23/24 · chegada | 24/24 · chegada | 24/24 · chegada | 24/24 · chegada |
| EVA-RT teste | 70 | 24/24 · chegada | 24/24 · chegada | 24/24 · chegada | 24/24 · chegada |

### Curva à esquerda: folga do sensor direito até a borda da linha (mm)

| Raio | Ângulo | L 70 | L 80 | L 85 | L 90 | L 95 | L 100 | L 107.1 |
|---:|---:|---:|---:|---:|---:|---:|---:|---:|
| 100 | 90° | 40.0 | 34.6 | 31.8 | 28.9 | 26.1 | 23.1 | 18.9 |
| 100 | 180° | 35.3 | 26.5 | 21.7 | 16.6 | 11.2 | 5.5 | -3.0 |
| 110 | 90° | 41.4 | 36.1 | 33.4 | 30.6 | 27.8 | 25.0 | 20.9 |
| 110 | 180° | 37.9 | 29.9 | 25.6 | 20.9 | 16.0 | 10.8 | 3.0 |
| 120 | 90° | 42.6 | 37.5 | 34.9 | 32.2 | 29.5 | 26.7 | 22.7 |
| 120 | 180° | 40.0 | 32.8 | 28.8 | 24.5 | 20.0 | 15.3 | 8.1 |
| 150 | 90° | 45.6 | 41.1 | 38.7 | 36.3 | 33.8 | 31.2 | 27.5 |
| 150 | 180° | 44.5 | 39.0 | 35.8 | 32.5 | 29.0 | 25.2 | 19.5 |
