therickmatos/Seguidor-de-linha/Estudo de caso - viabilidade do seguidor de linha/06_estudo_consolidado/imagens/pista_eva_rt_sobreposicao.png

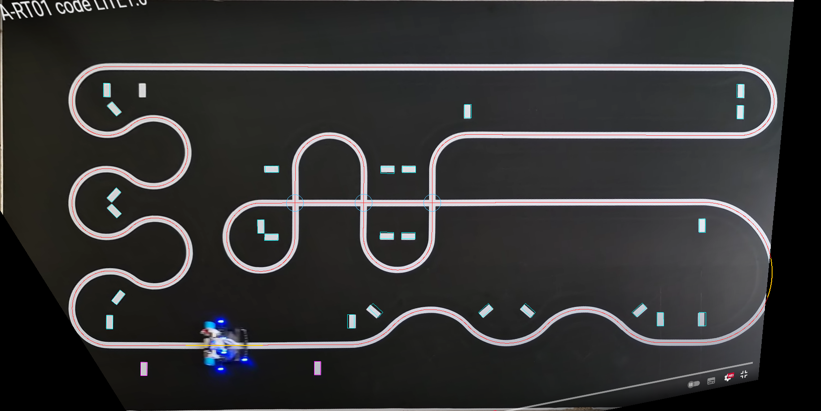
Estudo de caso - viabilidade do seguidor de linha/06_estudo_consolidado/imagens/pista_eva_rt_sobreposicao.png
