therickmatos/Seguidor-de-linha/Estudo de caso - viabilidade do seguidor de linha/06_estudo_consolidado/imagens/rascunho_retificacao_trif_2025.png

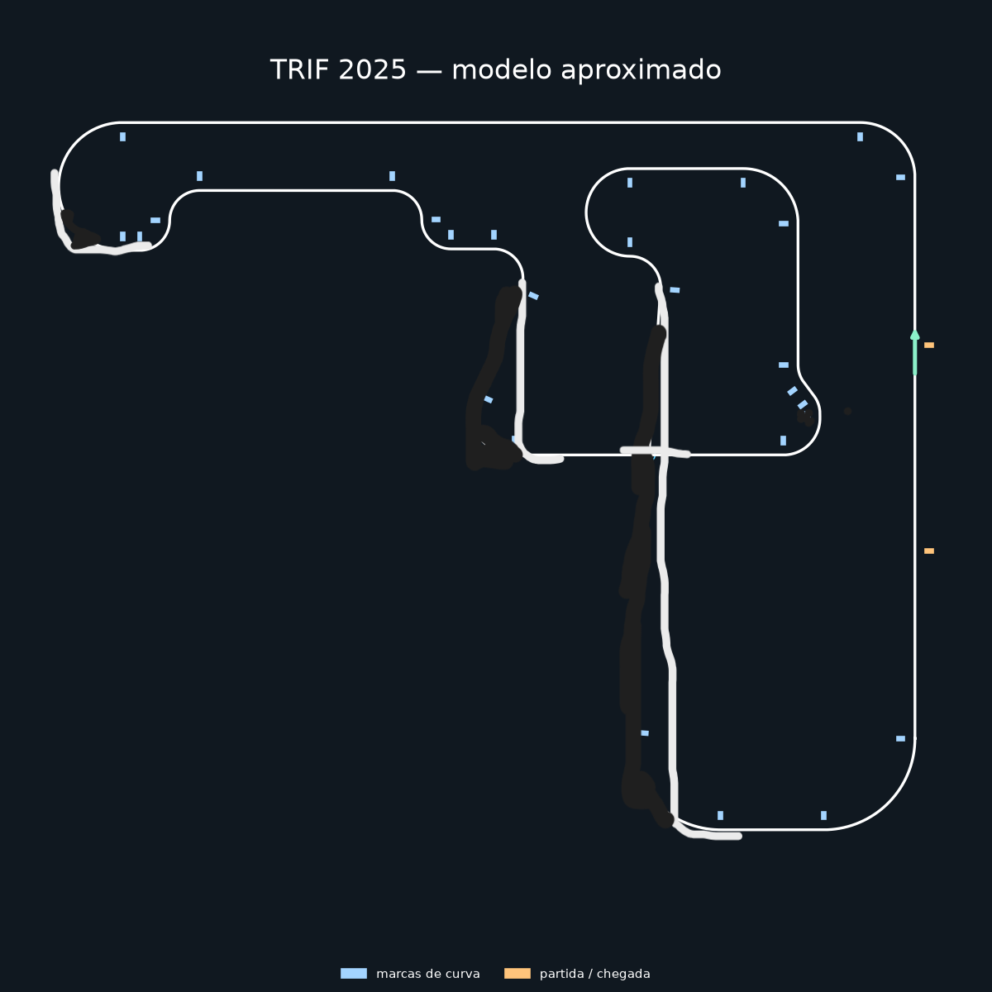
Estudo de caso - viabilidade do seguidor de linha/06_estudo_consolidado/imagens/rascunho_retificacao_trif_2025.png
