therickmatos/Seguidor-de-linha/Estudo de caso - viabilidade do seguidor de linha/06_estudo_consolidado/imagens/referencia_2025_angulo_2.png

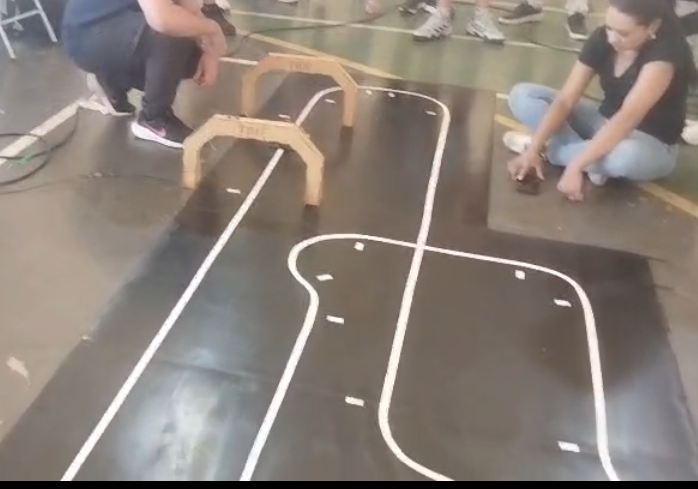
Estudo de caso - viabilidade do seguidor de linha/06_estudo_consolidado/imagens/referencia_2025_angulo_2.png
