therickmatos/Seguidor-de-linha/Estudo de caso - viabilidade do seguidor de linha/08_chassi_asa_de_gaivota/saida/ajustes_v81.png

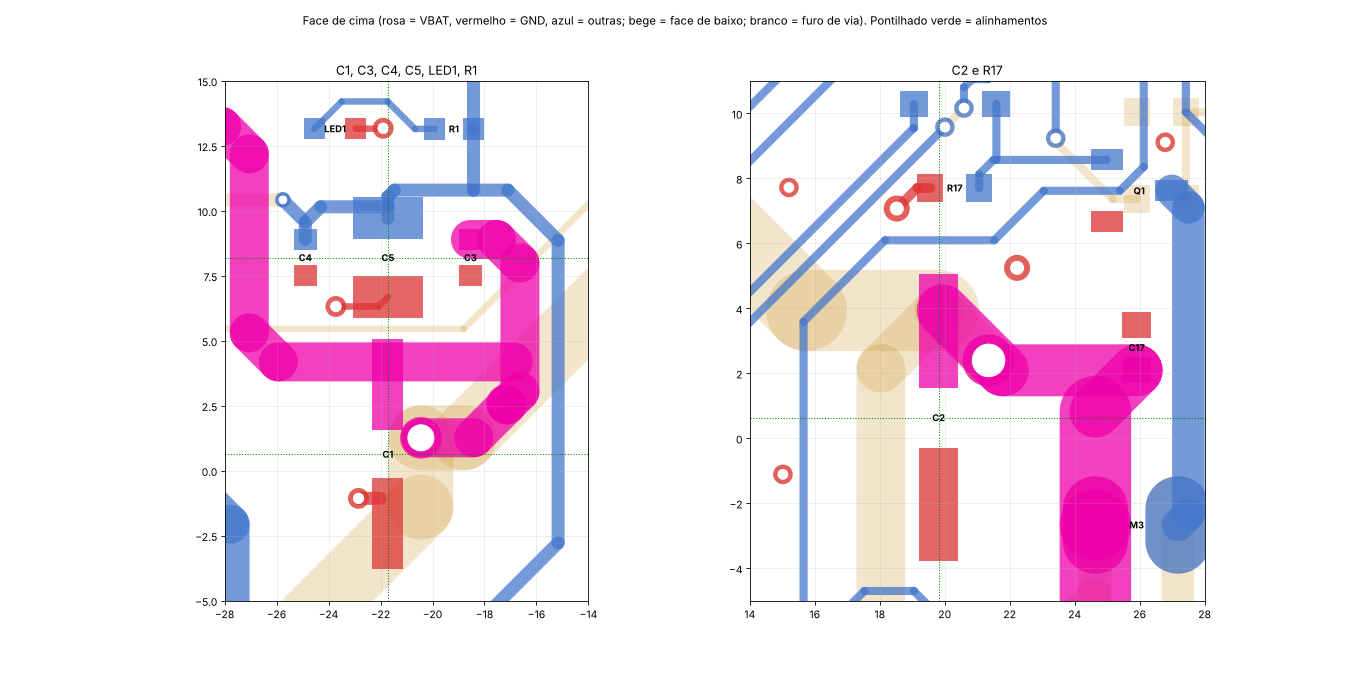
Estudo de caso - viabilidade do seguidor de linha/08_chassi_asa_de_gaivota/saida/ajustes_v81.png
