therickmatos/Seguidor-de-linha/Estudo de caso - viabilidade do seguidor de linha/08_chassi_asa_de_gaivota/saida/c1_c2_smd_v8.png

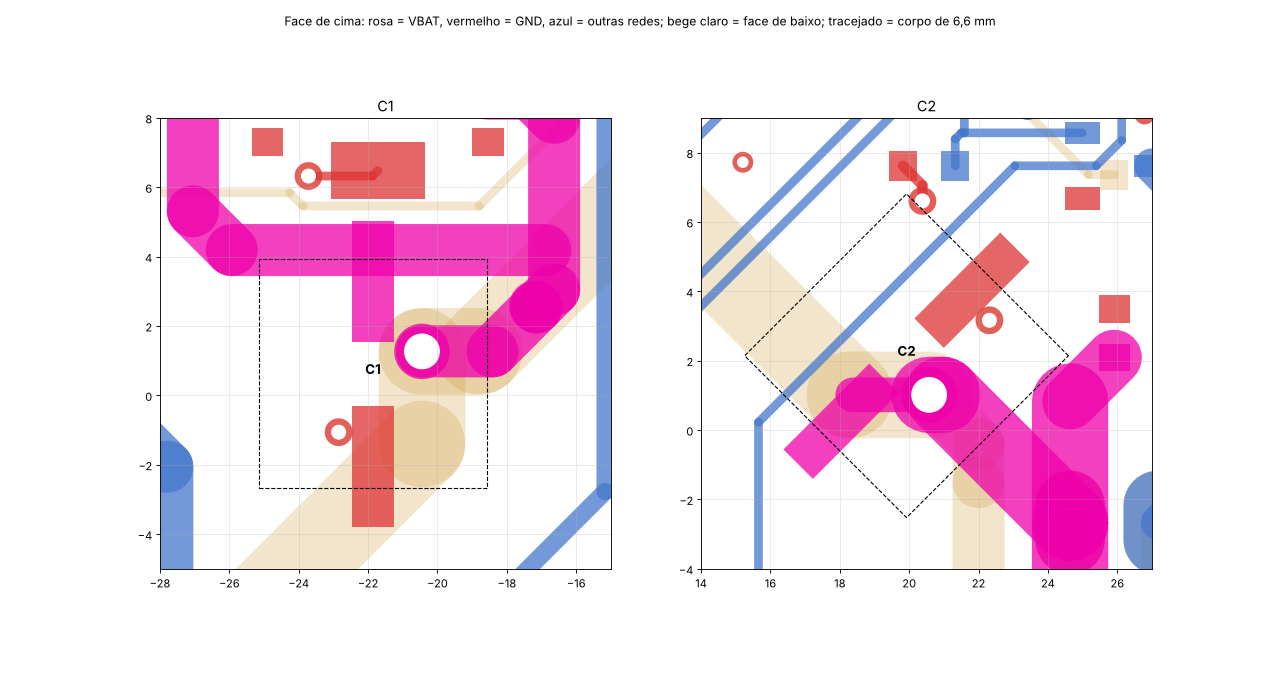
Estudo de caso - viabilidade do seguidor de linha/08_chassi_asa_de_gaivota/saida/c1_c2_smd_v8.png
