therickmatos/Seguidor-de-linha/Estudo de caso - viabilidade do seguidor de linha/08_chassi_asa_de_gaivota/saida/comparacao_minimo.png

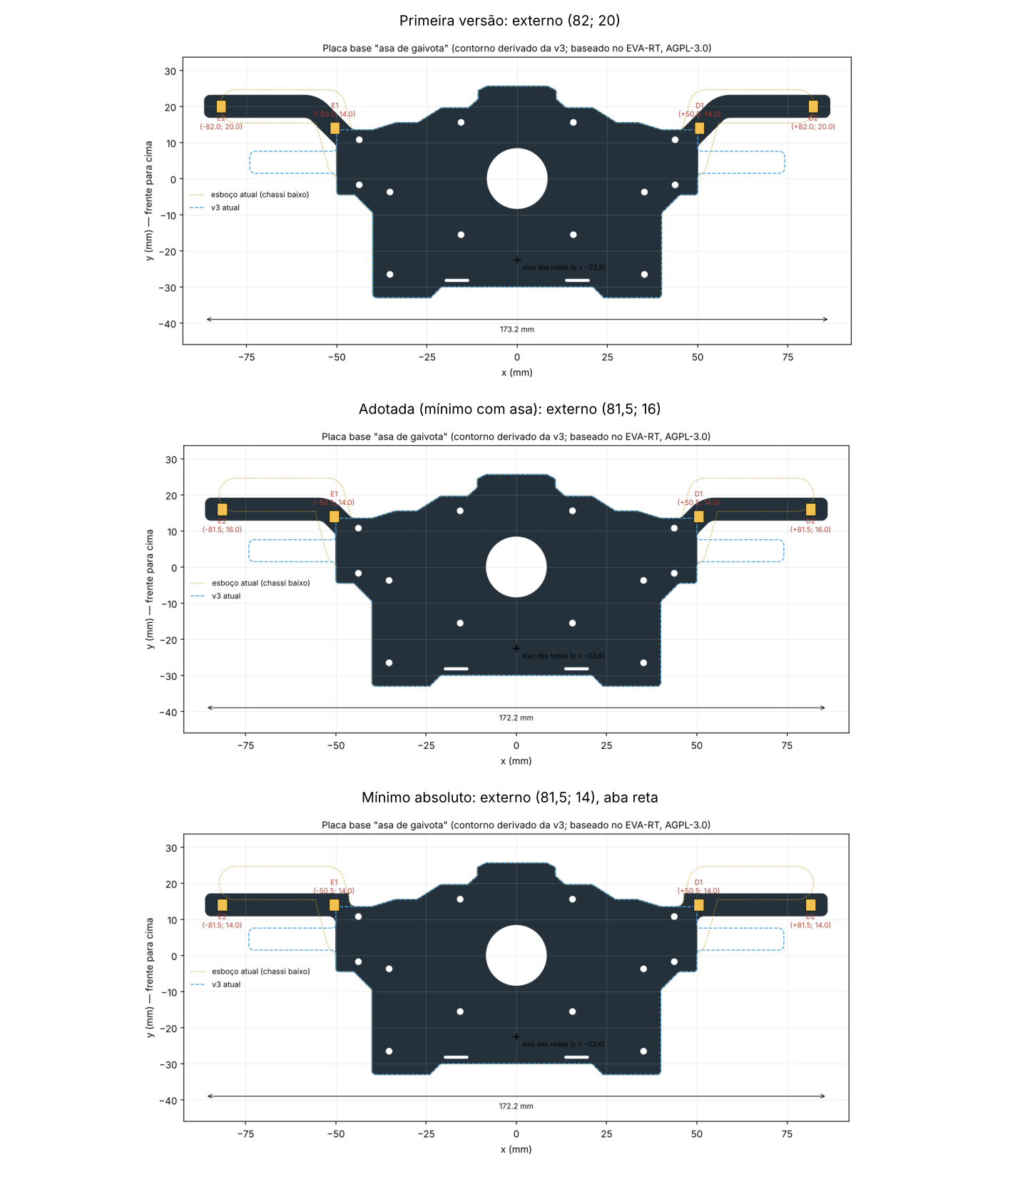
Estudo de caso - viabilidade do seguidor de linha/08_chassi_asa_de_gaivota/saida/comparacao_minimo.png
