therickmatos/Seguidor-de-linha/hardware/contorno/contorno_B_sobre_gerber_EVA-RT.jpg

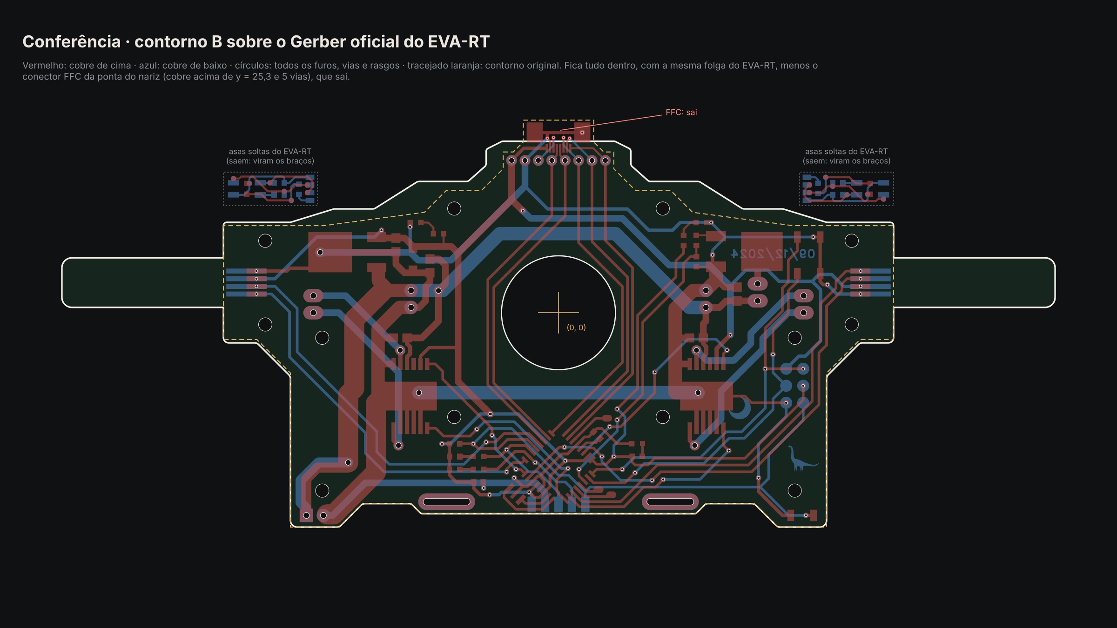
hardware/contorno/contorno_B_sobre_gerber_EVA-RT.jpg
