therickmatos/Seguidor-de-linha/hardware/contorno/marcas_x_regra_TRIF.jpg

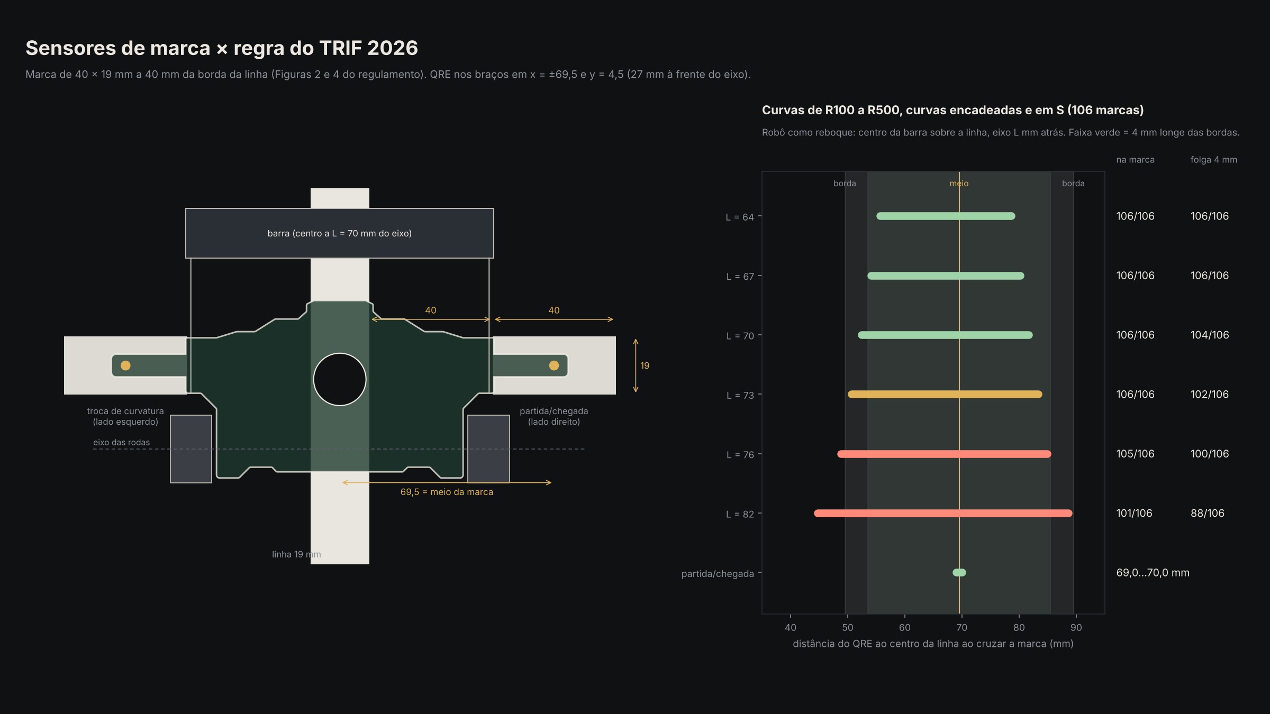
hardware/contorno/marcas_x_regra_TRIF.jpg
