therickmatos/Seguidor-de-linha/hardware/figuras/bt_frente_direita.png

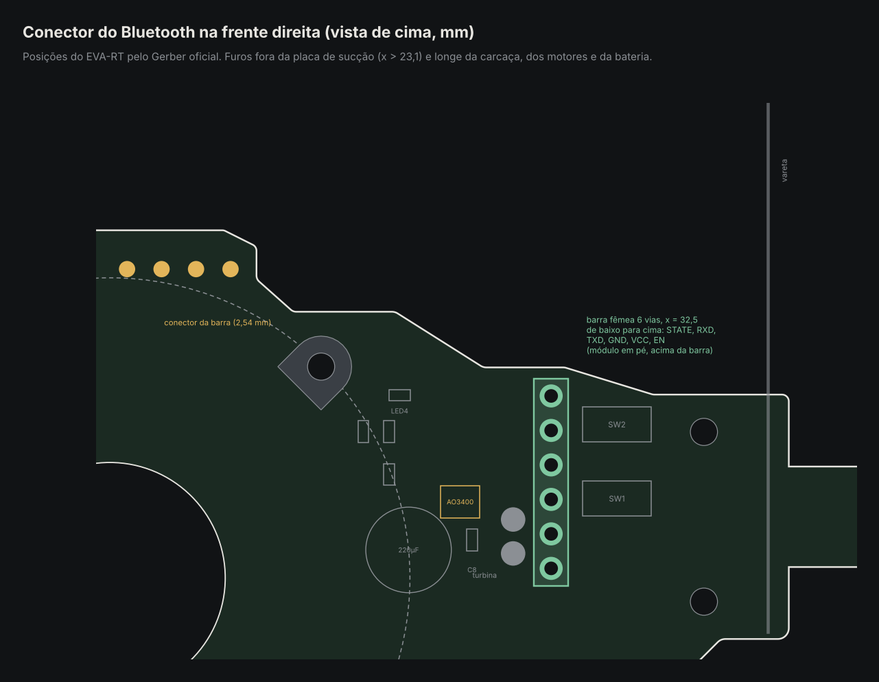
hardware/figuras/bt_frente_direita.png
