therickmatos/Seguidor-de-linha/Estudo de caso - viabilidade do seguidor de linha/02_referencias/stl/wheel_rim.stl

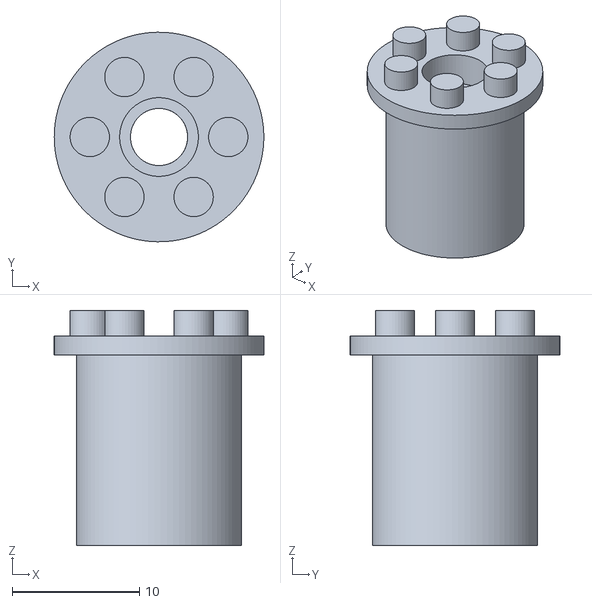
[picture p28: CAD file, 2026-11-04]
Estudo de caso - viabilidade do seguidor de linha/02_referencias/stl/wheel_rim.stl
16.5 x 16.5 x 18.5
