therickmatos/Seguidor-de-linha/Estudo de caso - viabilidade do seguidor de linha/08_chassi_asa_de_gaivota/modelo_3d/robo_v4.stl

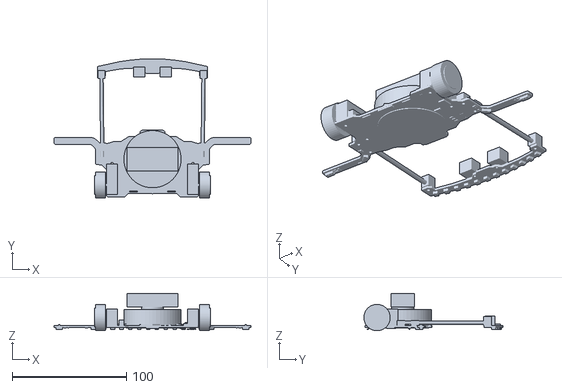
[picture p29: CAD file, 2026-11-11]
Estudo de caso - viabilidade do seguidor de linha/08_chassi_asa_de_gaivota/modelo_3d/robo_v4.stl
172.2 x 121.8 x 32.7
