therickmatos/Seguidor-de-linha/hardware/contorno/EVA-RT_contorno_B_degraus.dxf

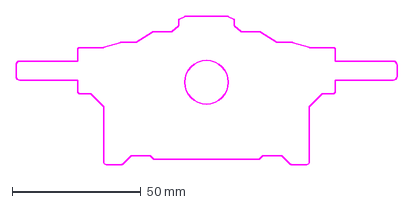
[picture p31: CAD file, 2026-11-04]
hardware/contorno/EVA-RT_contorno_B_degraus.dxf
148.2 x 57.6 mm
