therickmatos/Seguidor-de-linha/referencias/eva-rt/3d_models/impeller_base_2.stl

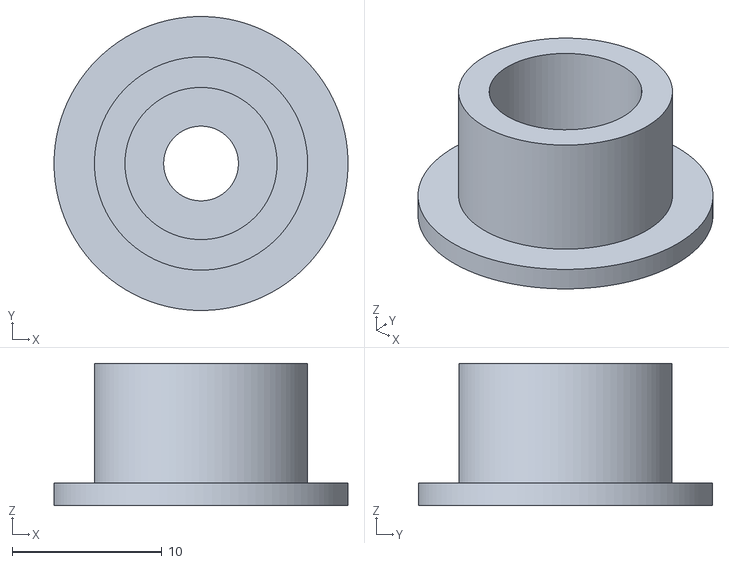
[picture p32: CAD file, 2026-11-04]
referencias/eva-rt/3d_models/impeller_base_2.stl
19.6 x 19.6 x 9.50
