therickmatos/Seguidor-de-linha/Estudo de caso - viabilidade do seguidor de linha/02_referencias/stl/barilla_connection.stl

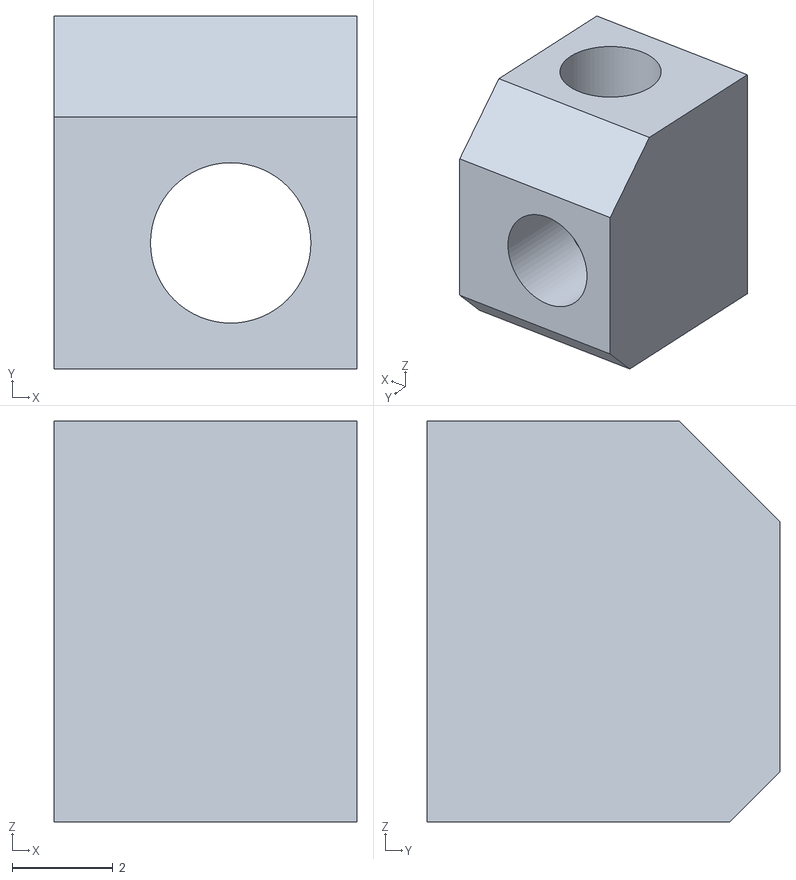
[picture p33: CAD file, 2026-11-04]
Estudo de caso - viabilidade do seguidor de linha/02_referencias/stl/barilla_connection.stl
6.00 x 7.00 x 7.95
