therickmatos/Seguidor-de-linha/referencias/eva-rt/3d_models/suction_base.stl

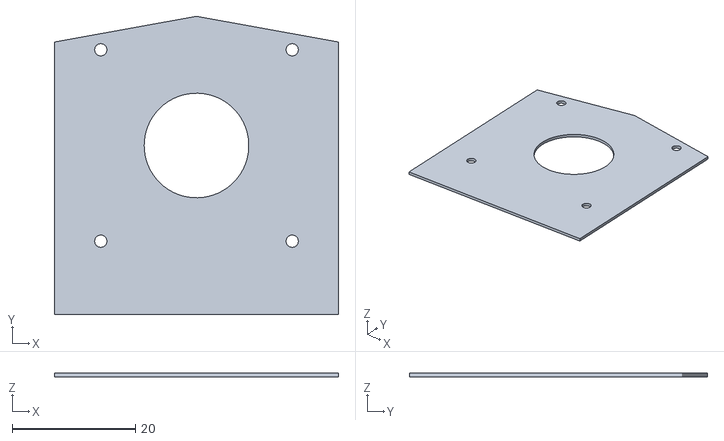
[picture p35: CAD file, 2026-11-04]
referencias/eva-rt/3d_models/suction_base.stl
46.2 x 48.5 x 0.6
