therickmatos/Seguidor-de-linha/Estudo de caso - viabilidade do seguidor de linha/02_referencias/stl/sensor_sledge.stl

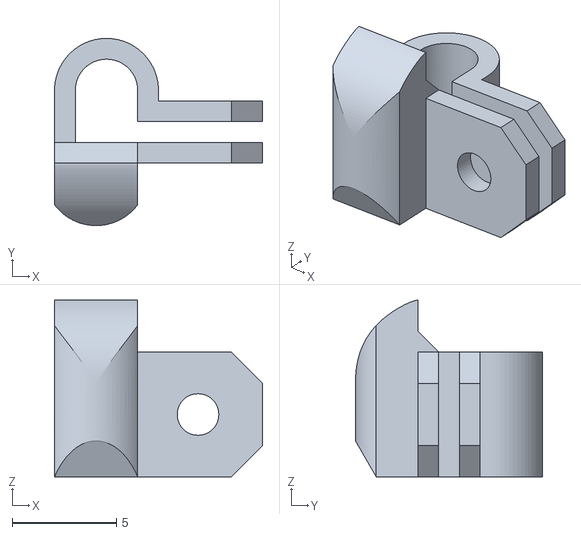
[picture p36: CAD file, 2026-11-04]
Estudo de caso - viabilidade do seguidor de linha/02_referencias/stl/sensor_sledge.stl
10.0 x 9.00 x 8.50
