therickmatos/Seguidor-de-linha/Estudo de caso - viabilidade do seguidor de linha/08_chassi_asa_de_gaivota/saida/primeira_versao_referencia.dxf

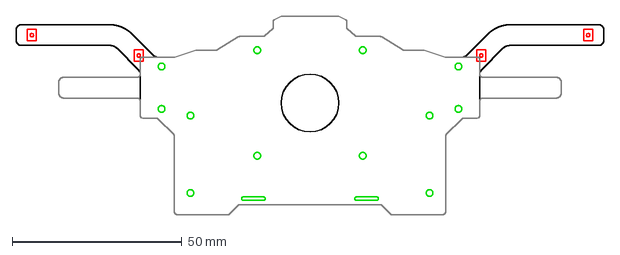
[picture p37: CAD file, 2026-11-11]
Estudo de caso - viabilidade do seguidor de linha/08_chassi_asa_de_gaivota/saida/primeira_versao_referencia.dxf
173.2 x 58.6 mm
