therickmatos/Seguidor-de-linha/referencias/eva-rt/3d_models/bead.stl

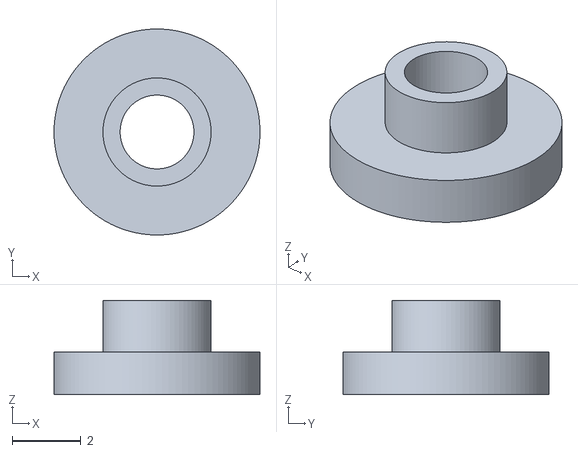
[picture p38: CAD file, 2026-11-04]
referencias/eva-rt/3d_models/bead.stl
6.00 x 6.00 x 2.75
