therickmatos/Seguidor-de-linha/Estudo de caso - viabilidade do seguidor de linha/02_referencias/stl/gearbox.stl

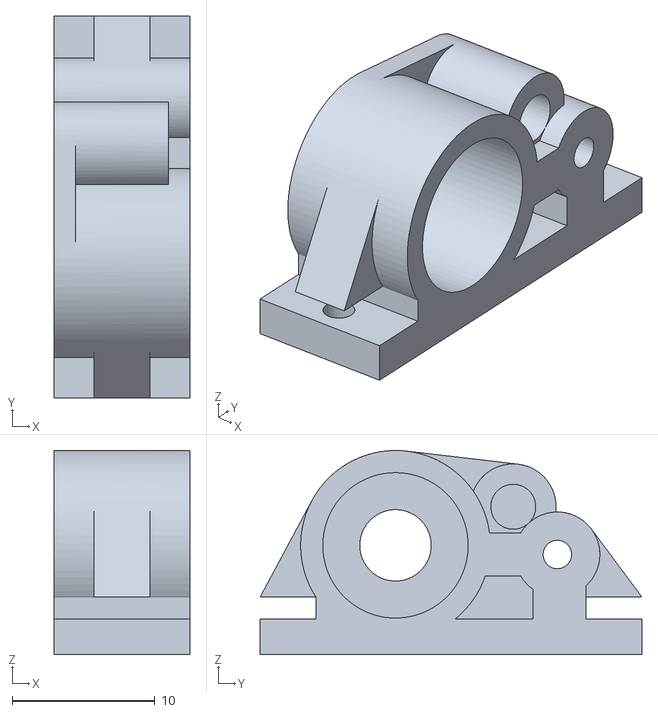
[picture p39: CAD file, 2026-11-04]
Estudo de caso - viabilidade do seguidor de linha/02_referencias/stl/gearbox.stl
9.50 x 26.7 x 14.3
