therickmatos/Seguidor-de-linha/referencias/eva-rt/3d_models/impeller_base_1.stl

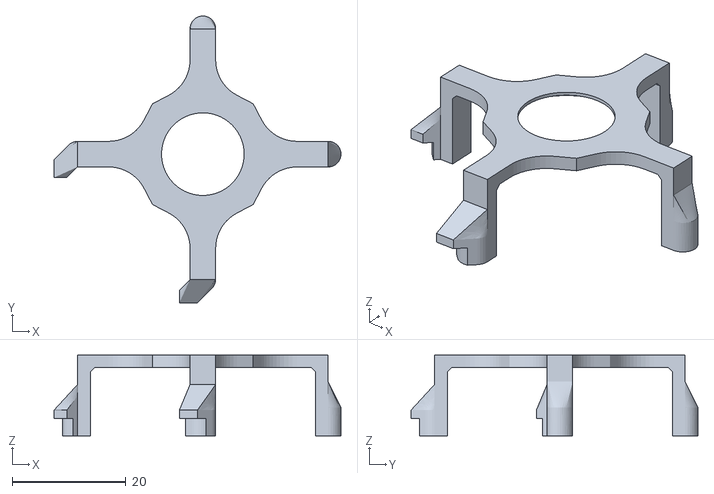
[picture p41: CAD file, 2026-11-04]
referencias/eva-rt/3d_models/impeller_base_1.stl
50.4 x 50.4 x 14.1
