therickmatos/Seguidor-de-linha/Estudo de caso - viabilidade do seguidor de linha/02_referencias/stl/barilla_clamp.stl

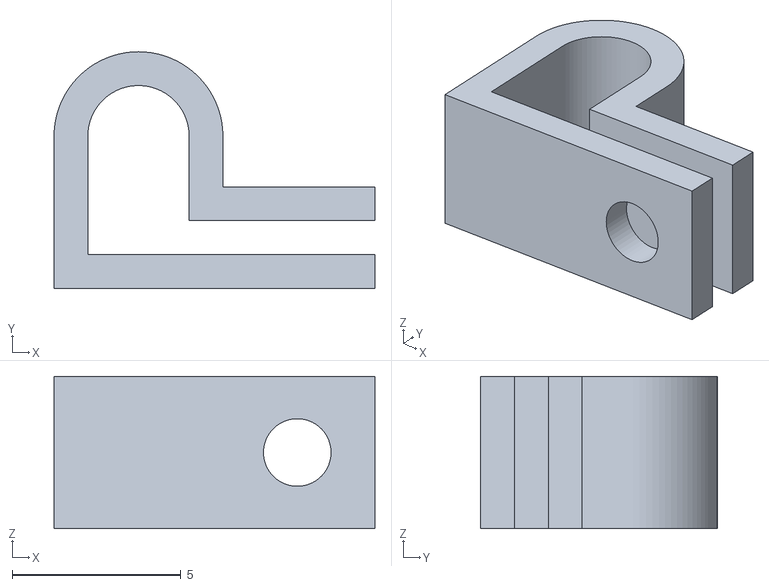
[picture p42: CAD file, 2026-11-04]
Estudo de caso - viabilidade do seguidor de linha/02_referencias/stl/barilla_clamp.stl
9.50 x 7.00 x 4.50
