therickmatos/Seguidor-de-linha/referencias/eva-rt/3d_models/battery_holder.stl

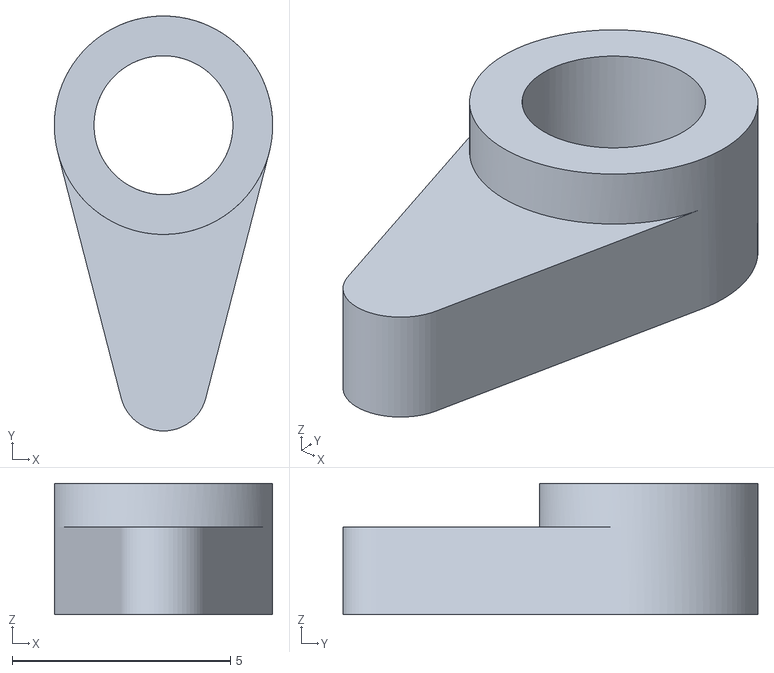
[picture p44: CAD file, 2026-11-04]
referencias/eva-rt/3d_models/battery_holder.stl
5.00 x 9.50 x 3.00
