therickmatos/Seguidor-de-linha/referencias/eva-rt/3d_models/impeller_fan.stl

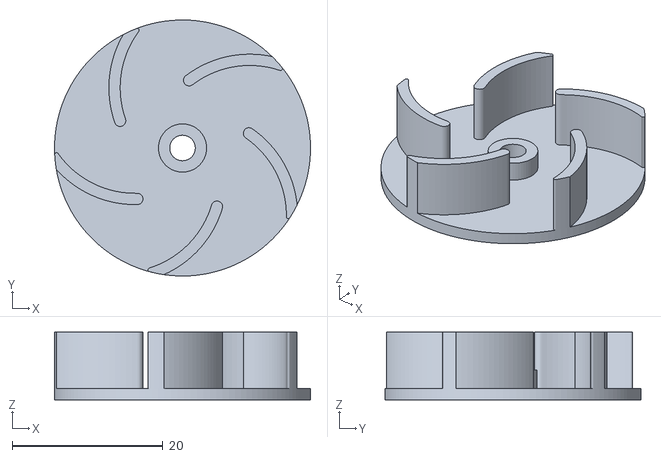
[picture p46: CAD file, 2026-11-04]
referencias/eva-rt/3d_models/impeller_fan.stl
34.0 x 34.0 x 9.00
