therickmatos/Seguidor-de-linha/Estudo de caso - viabilidade do seguidor de linha/08_chassi_asa_de_gaivota/saida/exemplo_minimo_reta_contorno.dxf

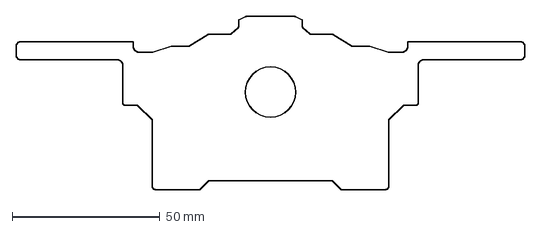
[picture p47: CAD file, 2026-11-11]
Estudo de caso - viabilidade do seguidor de linha/08_chassi_asa_de_gaivota/saida/exemplo_minimo_reta_contorno.dxf
172.2 x 58.6 mm
