therickmatos/Seguidor-de-linha/Estudo de caso - viabilidade do seguidor de linha/04_historico_exploratorio/resultado_432_passagens_nao_reproduzido.png

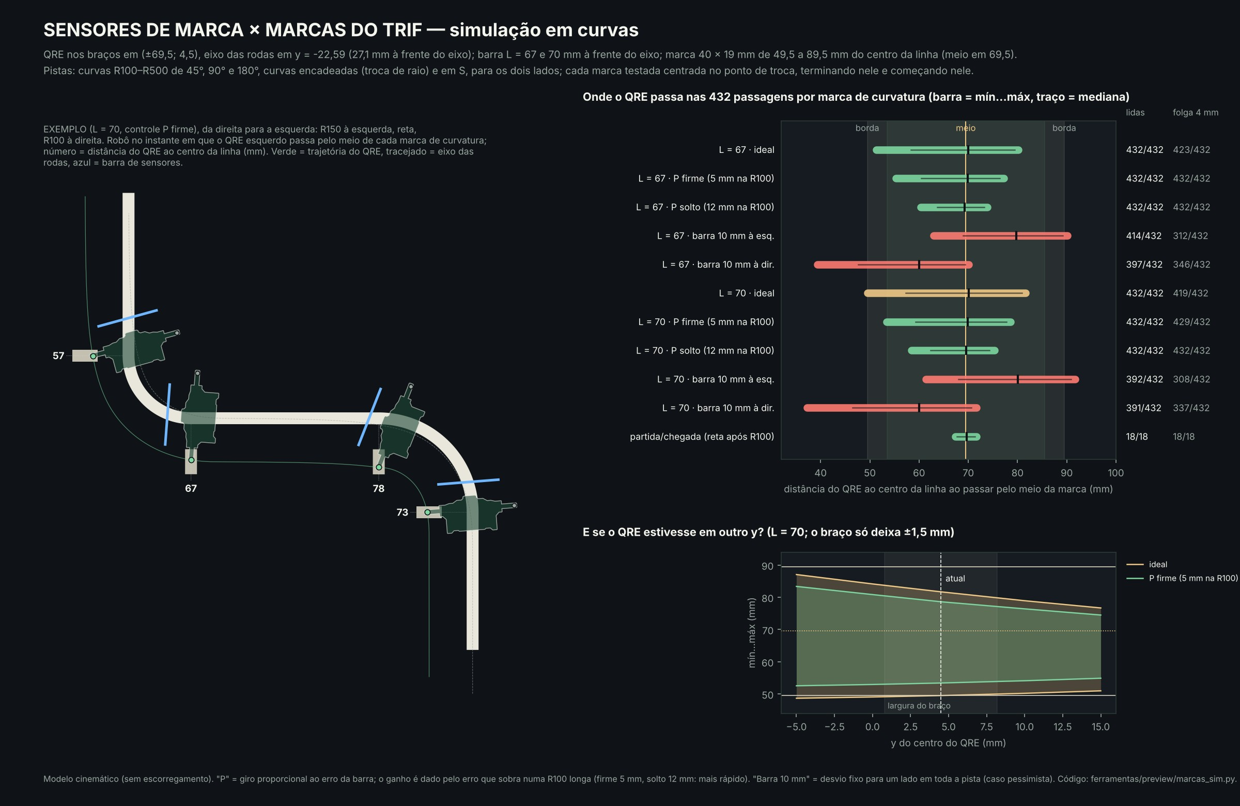
Estudo de caso - viabilidade do seguidor de linha/04_historico_exploratorio/resultado_432_passagens_nao_reproduzido.png
