therickmatos/Seguidor-de-linha/Estudo de caso - viabilidade do seguidor de linha/06_estudo_consolidado/imagens/pista_teste_eva_rt.png

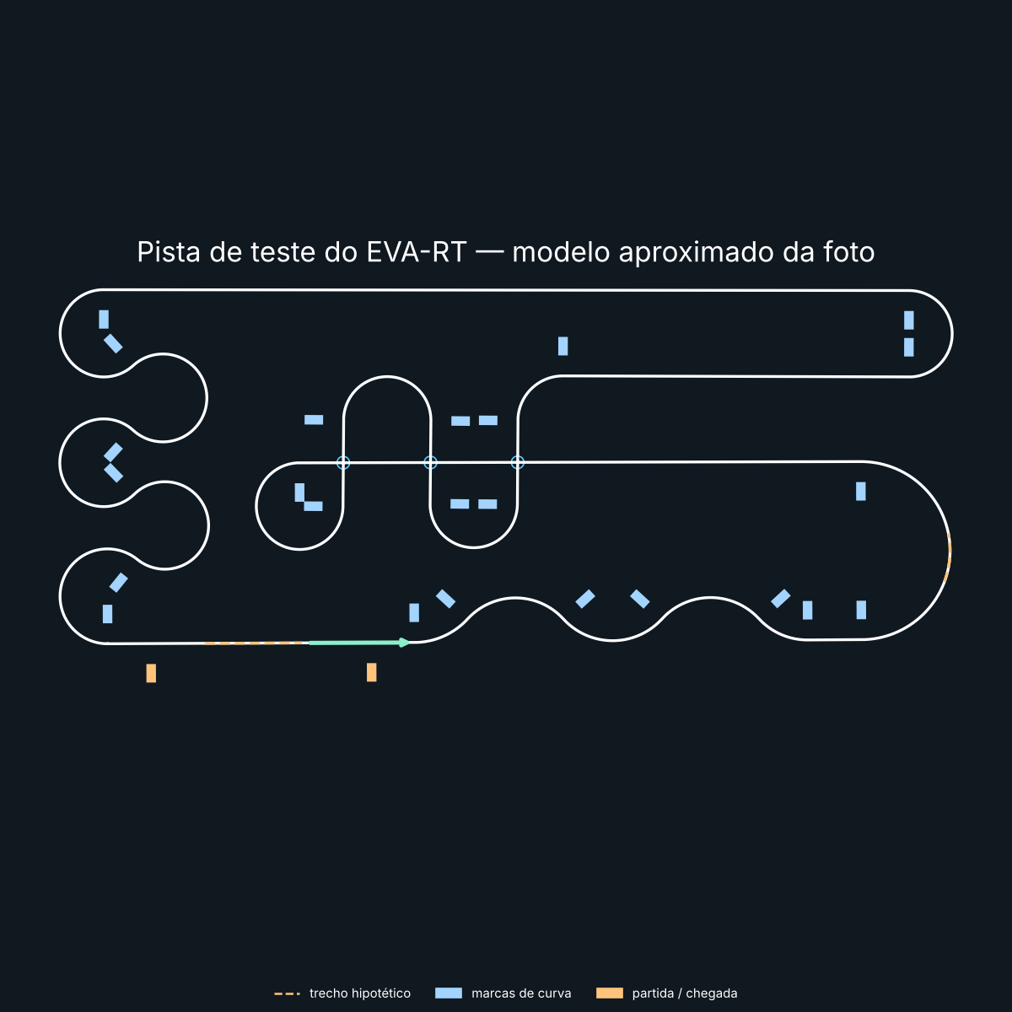
Estudo de caso - viabilidade do seguidor de linha/06_estudo_consolidado/imagens/pista_teste_eva_rt.png
