therickmatos/Seguidor-de-linha/hardware/seguidor_base/seguidor_base.pdf

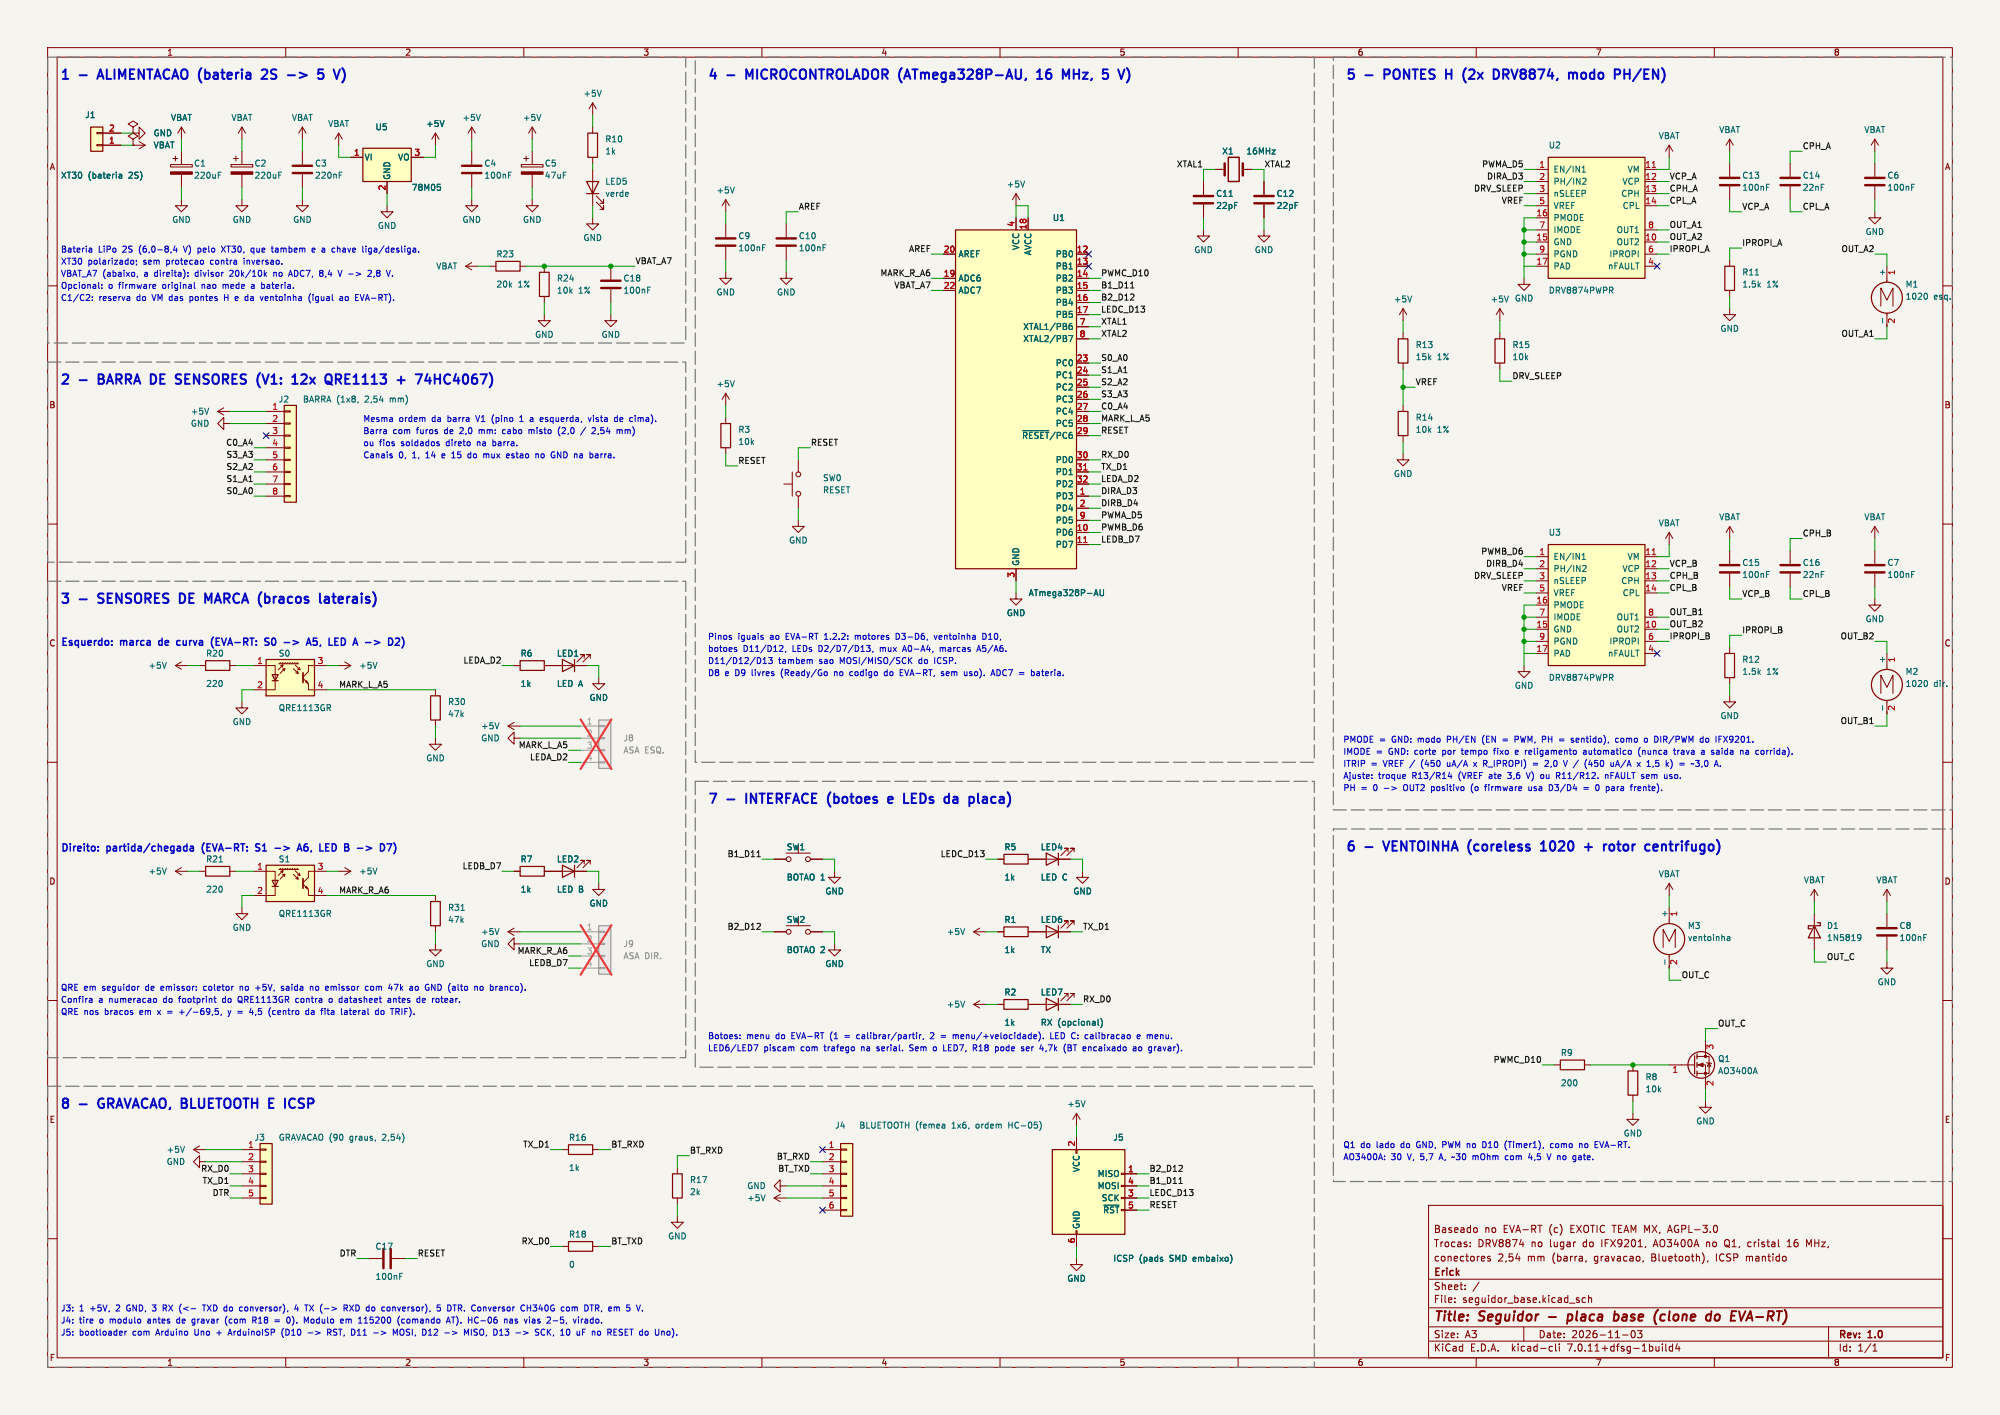
[picture p51: page 1]

5 - PONTES H (2x DRV8874, modo PH/EN)

2 SCK 3 MOSI 4 ~{RST}5 GND
MISO VCC

ICSP (pads SMD embaixo) MISO VCC

ICSP (pads SMD embaixo)

Id: 1/1 Title: Seguidor - placa base (clone do EVA-RT) File: seguidor_base.kicad_sch Sheet: / Erick
