therickmatos/Seguidor-de-linha/(list of files, drawings)

Other design files:
Estudo de caso - viabilidade do seguidor de linha/01_projeto/ProPrj_RUSH - SATURN - v3_2026-11-09.epro
Estudo de caso - viabilidade do seguidor de linha/08_chassi_asa_de_gaivota/codigo/v4_epro/entrada_erick_2026-11-12.epro
Estudo de caso - viabilidade do seguidor de linha/08_chassi_asa_de_gaivota/codigo/v4_epro/entrada_erick_v7_2026-11-13.epro
Estudo de caso - viabilidade do seguidor de linha/08_chassi_asa_de_gaivota/codigo/v4_epro/entrada_erick_v8_2026-11-13.epro
Estudo de caso - viabilidade do seguidor de linha/08_chassi_asa_de_gaivota/codigo/v4_epro/entrada_erick_v8f1_2026-11-14.epro
Estudo de caso - viabilidade do seguidor de linha/08_chassi_asa_de_gaivota/codigo/v4_epro/entrada_erick_v81_2026-11-14.epro
Estudo de caso - viabilidade do seguidor de linha/08_chassi_asa_de_gaivota/codigo/v4_epro/entrada_erick_v82_2026-11-14.epro
ProPrj_RUSH - SATURN - v4_asa_gaivota_2026-11-11.epro
ProPrj_RUSH - SATURN - v4_asa_gaivota_2026-11-12.epro
ProPrj_RUSH - SATURN - v8_2026-11-14.epro
ProPrj_RUSH - SATURN - v81_2026-11-14_corrigido.epro
ProPrj_RUSH - SATURN - v82_2026-11-14_corrigido.epro
ProPrj_RUSH - SATURN - v83_2026-11-14.epro
referencias/eva-rt/pcb_files/EVA_RT.eprj
