therickmatos/Seguidor-de-linha/hardware/seguidor_base/seguidor_base.kicad_sch

## KiCad design hardware/seguidor_base/seguidor_base.kicad_sch (2026-11-04)

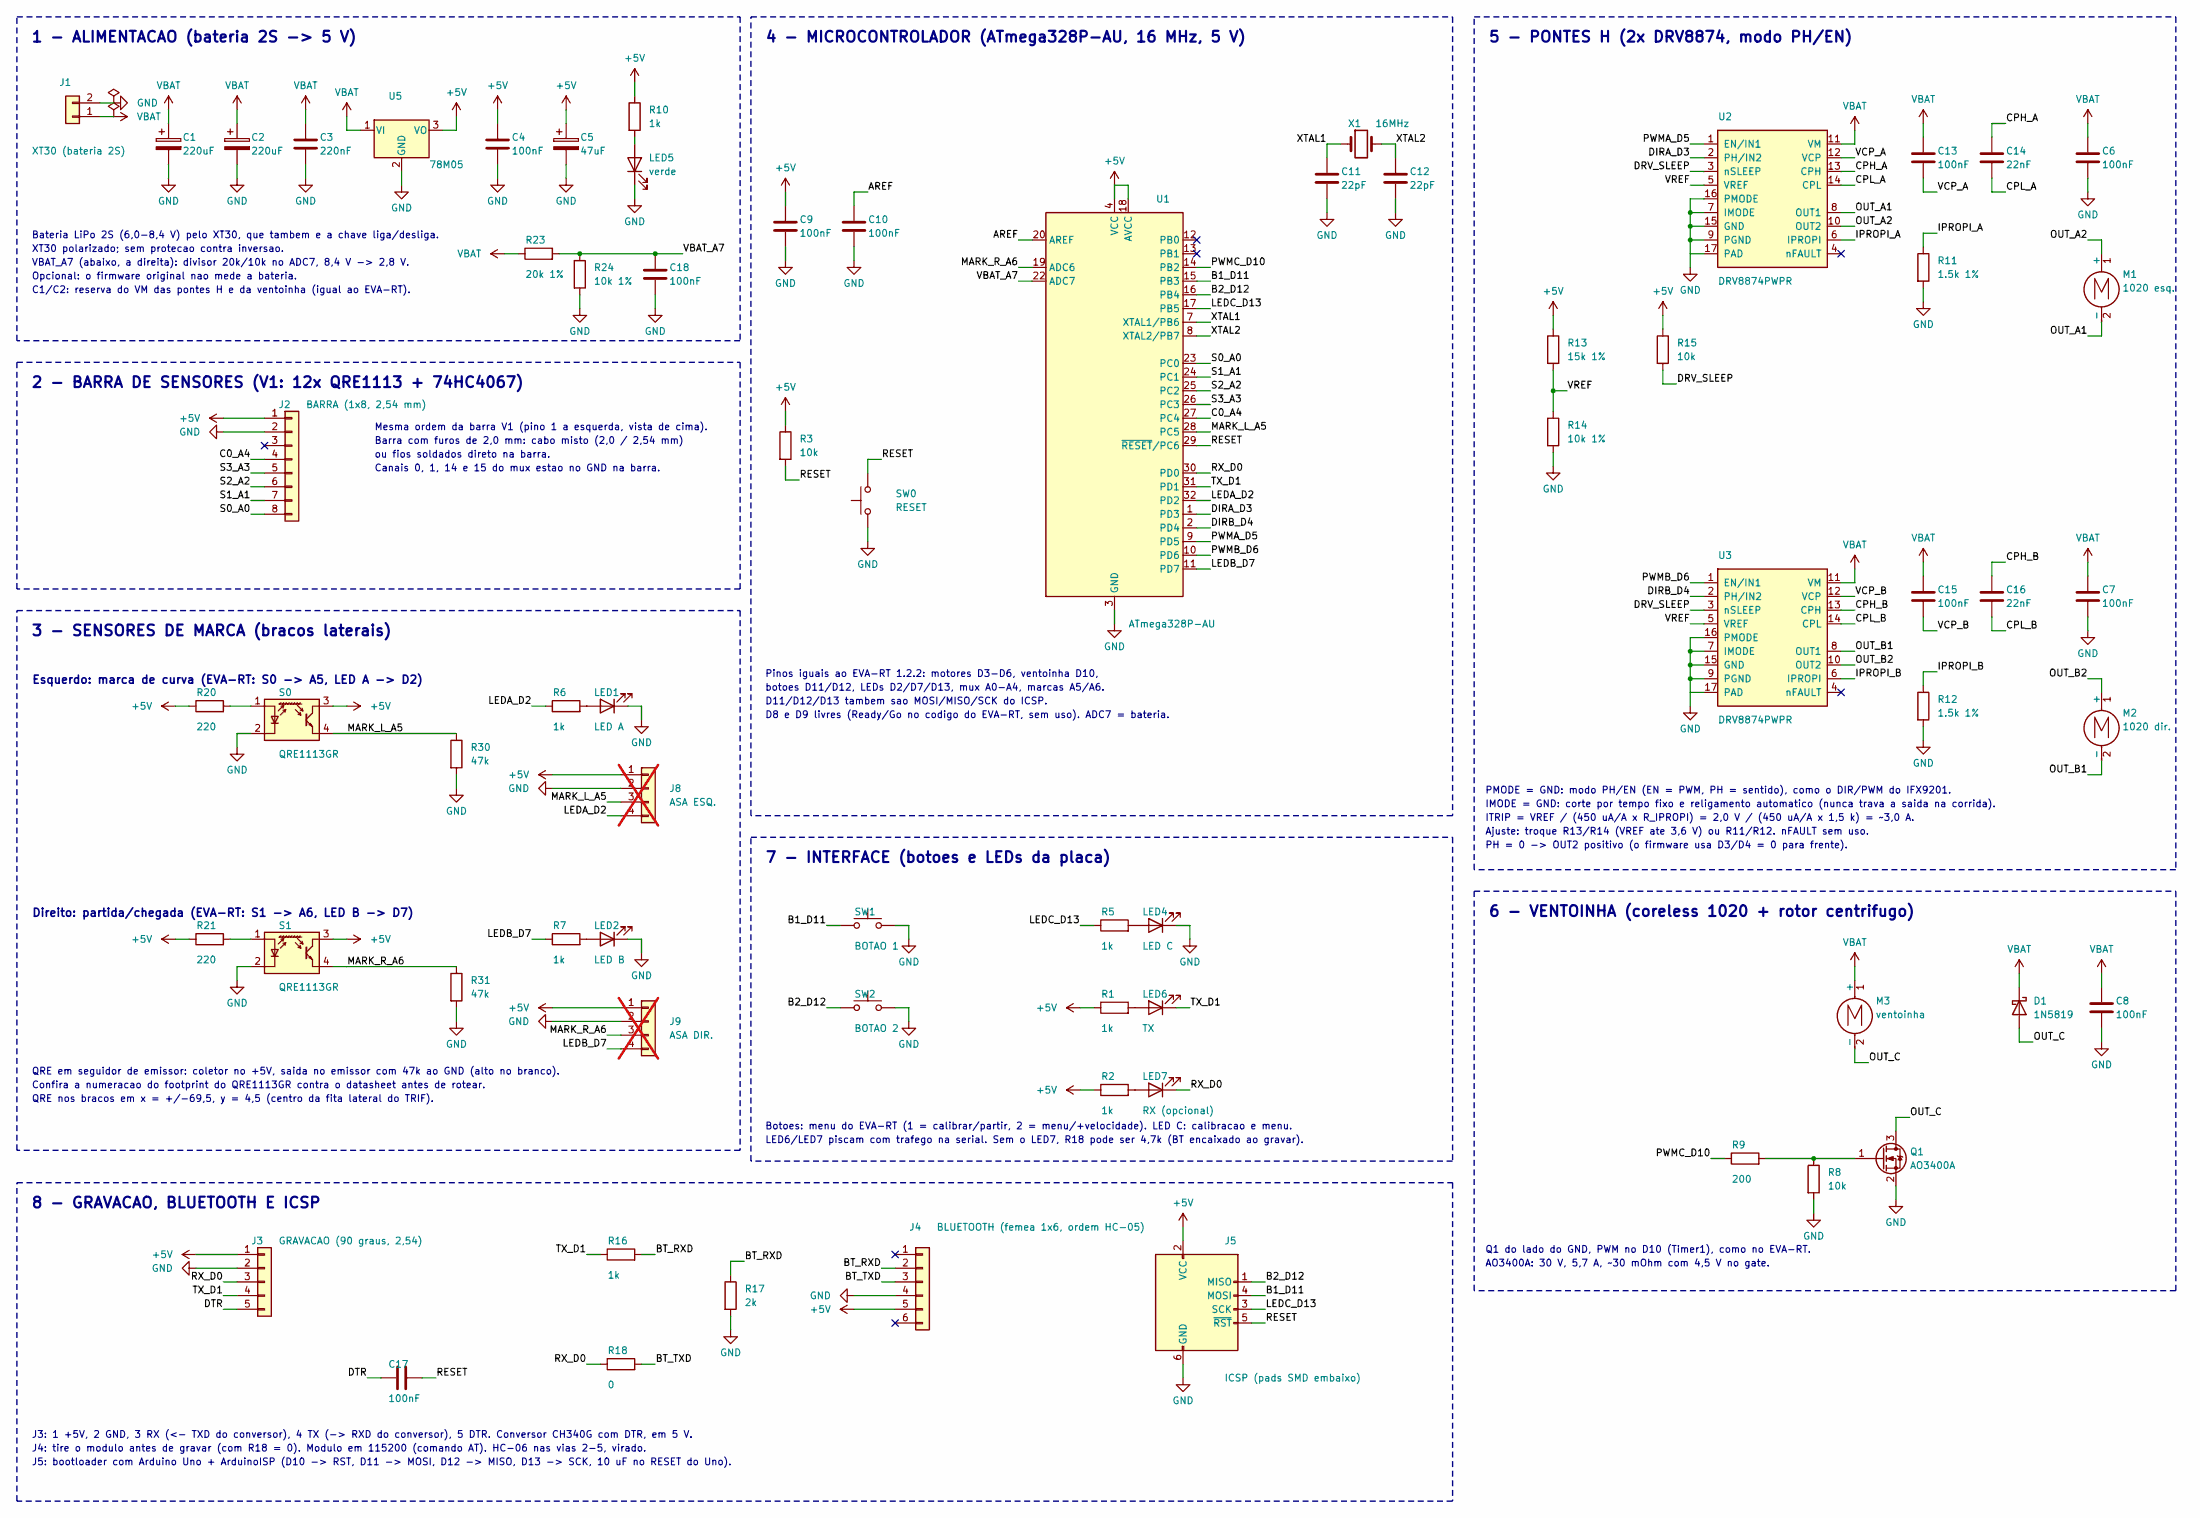
[picture p52: schematic seguidor_base.kicad_sch]

Parts:
C1, C2: 220uF
C3: 220nF
C4, C6, C7, C8, C9, C10, C13, C15, C17, C18: 100nF
C5: 47uF
C11, C12: 22pF
C14, C16: 22nF
D1: 1N5819
J1: XT30 (bateria 2S)
J2: BARRA (1x8, 2,54 mm)
J3: GRAVACAO (90 graus, 2,54)
J4: BLUETOOTH (femea 1x6, ordem HC-05)
J5: ICSP (pads SMD embaixo)
J8: ASA ESQ.; not fitted
J9: ASA DIR.; not fitted
LED1: LED A
LED2: LED B
LED4: LED C
LED5: verde
LED6: TX
LED7: RX (opcional)
M1: 1020 esq.
M2: 1020 dir.
M3: ventoinha
Q1: AO3400A; LCSC C20917
R1, R2, R5, R6, R7, R10, R16: 1k
R3, R8, R15: 10k
R9: 200
R11, R12: 1.5k 1%
R13: 15k 1%
R14, R24: 10k 1%
R17: 2k
R18: 0
R20, R21: 220
R23: 20k 1%
R30, R31: 47k
S0, S1: QRE1113GR
SW0: RESET
SW1: BOTAO 1
SW2: BOTAO 2
U1: ATmega328P-AU; LCSC C14877
U2, U3: DRV8874PWPR; LCSC C1855818
U5: 78M05; LCSC C111265
X1: 16MHz

Connections:
+5V: C4.1, C5.1, C9.1, J2.1, J3.1, J4.5, J5.2 (VCC), J8.1, J9.1, R1.1, R2.1, R3.1, R10.1, R13.1, R15.1, R20.1, R21.1, S0.3, S1.3, U1.4 (VCC), U1.6 (VCC), U1.18 (AVCC), U5.3 (VO)
AREF: C10.1, U1.20 (AREF)
B1_D11: J5.4 (MOSI), SW1.1, U1.15 (PB3)
B2_D12: J5.1 (MISO), SW2.1, U1.16 (PB4)
BT_RXD: J4.2, R16.2, R17.1
BT_TXD: J4.3, R18.2
C0_A4: J2.4, U1.27 (PC4)
CPH_A: C14.1, U2.13 (CPH)
CPH_B: C16.1, U3.13 (CPH)
CPL_A: C14.2, U2.14 (CPL)
CPL_B: C16.2, U3.14 (CPL)
DIRA_D3: U1.1 (PD3), U2.2 (PH/IN2)
DIRB_D4: U1.2 (PD4), U3.2 (PH/IN2)
DRV_SLEEP: R15.2, U2.3 (nSLEEP), U3.3 (nSLEEP)
DTR: C17.1, J3.5
GND: C1.2, C2.2, C3.2, C4.2, C5.2, C6.2, C7.2, C8.2, C9.2, C10.2, C11.2, C12.2, C18.2, J1.2, J2.2, J3.2, J4.4, J5.6 (GND), J8.2, J9.2, LED1.1 (K), LED2.1 (K), LED4.1 (K), LED5.1 (K), Q1.2 (S), R8.2, R11.2, R12.2, R14.2, R17.2, R24.2, R30.2, R31.2, S0.2 (K), S1.2 (K), SW0.1, SW1.2, SW2.2, U1.3 (GND), U1.5 (GND), U1.21 (GND), U2.7 (IMODE), U2.9 (PGND), U2.15 (GND), U2.16 (PMODE), U2.17 (PAD), U3.7 (IMODE), U3.9 (PGND), U3.15 (GND), U3.16 (PMODE), U3.17 (PAD), U5.2 (GND)
IPROPI_A: R11.1, U2.6 (IPROPI)
IPROPI_B: R12.1, U3.6 (IPROPI)
LEDA_D2: J8.4, R6.1, U1.32 (PD2)
LEDB_D7: J9.4, R7.1, U1.11 (PD7)
LEDC_D13: J5.3 (SCK), R5.1, U1.17 (PB5)
MARK_L_A5: J8.3, R30.1, S0.4, U1.28 (PC5)
MARK_R_A6: J9.3, R31.1, S1.4, U1.19 (ADC6)
unnamed: LED1.2 (A), R6.2
unnamed: LED2.2 (A), R7.2
unnamed: LED4.2 (A), R5.2
unnamed: LED5.2 (A), R10.2
unnamed: LED6.2 (A), R1.2
unnamed: LED7.2 (A), R2.2
unnamed: Q1.1 (G), R8.1, R9.2
unnamed: R20.2, S0.1 (A)
unnamed: R21.2, S1.1 (A)
OUT_A1: M1.2 (-), U2.8 (OUT1)
OUT_A2: M1.1 (+), U2.10 (OUT2)
OUT_B1: M2.2 (-), U3.8 (OUT1)
OUT_B2: M2.1 (+), U3.10 (OUT2)
OUT_C: D1.2 (A), M3.2 (-), Q1.3 (D)
PWMA_D5: U1.9 (PD5), U2.1 (EN/IN1)
PWMB_D6: U1.10 (PD6), U3.1 (EN/IN1)
PWMC_D10: R9.1, U1.14 (PB2)
RESET: C17.2, J5.5 (~RST), R3.2, SW0.2, U1.29 (~RESET/PC6)
RX_D0: J3.3, LED7.1 (K), R18.1, U1.30 (PD0)
S0_A0: J2.8, U1.23 (PC0)
S1_A1: J2.7, U1.24 (PC1)
S2_A2: J2.6, U1.25 (PC2)
S3_A3: J2.5, U1.26 (PC3)
TX_D1: J3.4, LED6.1 (K), R16.1, U1.31 (PD1)
VBAT: C1.1, C2.1, C3.1, C6.1, C7.1, C8.1, C13.1, C15.1, D1.1 (K), J1.1, M3.1 (+), R23.1, U2.11 (VM), U3.11 (VM), U5.1 (VI)
VBAT_A7: C18.1, R23.2, R24.1, U1.22 (ADC7)
VCP_A: C13.2, U2.12 (VCP)
VCP_B: C15.2, U3.12 (VCP)
VREF: R13.2, R14.1, U2.5 (VREF), U3.5 (VREF)
XTAL1: C11.1, U1.7 (XTAL1/PB6), X1.1
XTAL2: C12.1, U1.8 (XTAL2/PB7), X1.2

Notes on the sheet:
1 - ALIMENTACAO (bateria 2S -> 5 V)
Bateria LiPo 2S (6,0-8,4 V) pelo XT30, que tambem e a chave liga/desliga.
XT30 polarizado; sem protecao contra inversao.
VBAT_A7 (abaixo, a direita): divisor 20k/10k no ADC7, 8,4 V -> 2,8 V.
Opcional: o firmware original nao mede a bateria.
C1/C2: reserva do VM das pontes H e da ventoinha (igual ao EVA-RT).
2 - BARRA DE SENSORES (V1: 12x QRE1113 + 74HC4067)
Mesma ordem da barra V1 (pino 1 a esquerda, vista de cima).
Barra com furos de 2,0 mm: cabo misto (2,0 / 2,54 mm)
ou fios soldados direto na barra.
Canais 0, 1, 14 e 15 do mux estao no GND na barra.
3 - SENSORES DE MARCA (bracos laterais)
Esquerdo: marca de curva (EVA-RT: S0 -> A5, LED A -> D2)
Direito: partida/chegada (EVA-RT: S1 -> A6, LED B -> D7)
QRE em seguidor de emissor: coletor no +5V, saida no emissor com 47k ao GND (alto no branco).
Confira a numeracao do footprint do QRE1113GR contra o datasheet antes de rotear.
QRE nos bracos em x = +/-69,5, y = 4,5 (centro da fita lateral do TRIF).
4 - MICROCONTROLADOR (ATmega328P-AU, 16 MHz, 5 V)
Pinos iguais ao EVA-RT 1.2.2: motores D3-D6, ventoinha D10,
botoes D11/D12, LEDs D2/D7/D13, mux A0-A4, marcas A5/A6.
D11/D12/D13 tambem sao MOSI/MISO/SCK do ICSP.
D8 e D9 livres (Ready/Go no codigo do EVA-RT, sem uso). ADC7 = bateria.
5 - PONTES H (2x DRV8874, modo PH/EN)
PMODE = GND: modo PH/EN (EN = PWM, PH = sentido), como o DIR/PWM do IFX9201.
IMODE = GND: corte por tempo fixo e religamento automatico (nunca trava a saida na corrida).
ITRIP = VREF / (450 uA/A x R_IPROPI) = 2,0 V / (450 uA/A x 1,5 k) = ~3,0 A.
Ajuste: troque R13/R14 (VREF ate 3,6 V) ou R11/R12. nFAULT sem uso.
PH = 0 -> OUT2 positivo (o firmware usa D3/D4 = 0 para frente).
6 - VENTOINHA (coreless 1020 + rotor centrifugo)
Q1 do lado do GND, PWM no D10 (Timer1), como no EVA-RT.
AO3400A: 30 V, 5,7 A, ~30 mOhm com 4,5 V no gate.
7 - INTERFACE (botoes e LEDs da placa)
Botoes: menu do EVA-RT (1 = calibrar/partir, 2 = menu/+velocidade). LED C: calibracao e menu.
LED6/LED7 piscam com trafego na serial. Sem o LED7, R18 pode ser 4,7k (BT encaixado ao gravar).
8 - GRAVACAO, BLUETOOTH E ICSP
J3: 1 +5V, 2 GND, 3 RX (<- TXD do conversor), 4 TX (-> RXD do conversor), 5 DTR. Conversor CH340G com DTR, em 5 V.
J4: tire o modulo antes de gravar (com R18 = 0). Modulo em 115200 (comando AT). HC-06 nas vias 2-5, virado.
J5: bootloader com Arduino Uno + ArduinoISP (D10 -> RST, D11 -> MOSI, D12 -> MISO, D13 -> SCK, 10 uF no RESET do Uno).
