therickmatos/Seguidor-de-linha/(commit log)

2026-11-04 Projeto do seguidor baseado no EVA-RT: docs, contorno, esquemático e referências
    - Decisões do seguidor, contorno B definitivo (DXF + figuras de conferência)
    - Esquemático rev 1.0 (PDF, BOM, projeto KiCad em kicad/) como referência
    para o port ao EasyEDA Pro, com REDES.md (54 redes, 7 pinos sem ligação)
    gerado da netlist do KiCad
    - Gerber da barra V1, posição do conector do Bluetooth
    - Cópia do EVA-RT (EasyEDA Pro, Gerbers, PDFs, STL, firmware), AGPL-3.0
    - Docs do perseguidor e do plano B em fenolite em subpastas
    Fora do repositório: conversa e anexos, scripts geradores, netlist .net,
    figuras de alternativas descartadas e renders PNG do EVA-RT.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
    [BOM_seguidor_base.csv, EVA-RT_contorno_B_degraus.dxf, EVA_RT.eprj, barilla_clamp.stl, barilla_connection.stl, battery_holder.stl, bead.stl, gearbox.stl]
2026-11-04 KiCad como fonte do esquemático; perseguidor e fenolite fora do repositório
    - Volta ferramentas/esquematico/ (gen.py e companhia), que gera o
    esquemático KiCad; novo redes.py gera o REDES.md
    - Projeto KiCad de volta em hardware/seguidor_base/ (mesma estrutura do
    pacote do make_pkg.py, para publicar com um cp)
    - REDES.md avisa dos pinos de alimentação escondidos e empilhados do
    ATmega (U1.5, U1.6, U1.21), que podem se soltar na importação no EasyEDA
    - Remove os docs do perseguidor e do seguidor em fenolite (outros projetos)
    - README, CLAUDE.md e docs: fluxo KiCad (fonte) → EasyEDA Pro → JLC
    Claude-Session: https://claud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
    [seguidor_base.kicad_sch]
2026-11-10 Adiciona estudo de caso da viabilidade do seguidor de linha
    Preserva CAD recebido, referências e simulações 17/19, 19/19 e 6/7,
    com auditoria dos casos exploratórios, limitações e reprodução.
    [ProPrj_RUSH - SATURN - v3_2026-11-09.epro, barilla_clamp.stl, barilla_connection.stl, gearbox.stl, passagens_marcas.csv, sensor_sledge.stl, wheel_rim.stl]
2026-11-10 Ajusta escala do modelo de 2025 e recalcula leituras
2026-11-10 Adiciona teste do chassi baixo com dois sensores por lado
    Inclui o contorno com recortes do v3, leitura única por marca e comparação nas pistas de 2024 e 2025. Validação independente por marca em 60, 65 e 70 mm entre furos e testes da interface no Chrome.
2026-11-11 Adiciona análise da lógica de marcas do firmware EVA-RT e varredura de L
    Emula Marks.ino (EVA-RT 1.2.2) sobre as pistas do estudo 06, varre a
    distância eixo-barra (L) e a posição do sensor lateral, e calcula a folga
    do sensor direito em curvas fechadas à esquerda. Inclui a figura da camada
    Document do EVA_RT_PCB e a foto de referência da pista de teste do EVA-RT.
    Baseado no EVA-RT, (c) EXOTIC TEAM MX, AGPL-3.0.
    Claude-Session: https://claude.ai/code/session_01LzVZu4cQTu9W86fzFANnuh
2026-11-11 Corrige sentido da pista TRIF 2024, adiciona pista de teste do EVA-RT e análise de L
    Simulador (06_estudo_consolidado):
    - TRIF 2024 percorrida no sentido contrário, com o mesmo desenho; marcas
    regeradas pela regra (curva à esquerda, partida/chegada à direita).
    - Nova pista: modelo aproximado da pista de teste do EVA-RT, reconstruído
    de um quadro do vídeo (três cruzamentos, raios de 101 a 208 mm).
    - Novas configurações: v3 atual com L 70 e 85 mm e EVA-RT original (L 100).
    O simulador passa a abrir na v3 com L 70 mm.
    - Teste de interface atualizado para as três pistas.
    Análise (07_firmware_e_geometria):
    - A v3, com um QRE por lado, lê todas as marcas das três pistas com
    L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
2026-11-11 Adiciona chassi asa de gaivota com dois QRE por lado
    Estudo 08: varredura da posição dos quatro sensores com a barra a
    63-65 mm entre furos (TRIF 2024/2025, desvio fixo e "abre na curva"),
    escolha E1/D1 em (±50,5; 14) e E2/D2 em (±82; 20), contorno derivado
    da v3 (corpo, frente, traseira e recortes iguais) em DXF e verificação
    em passo de 0,25 mm. O simulador passa a abrir com a nova placa e o
    teste automático confere as contagens com o Python.
    Baseado no EVA-RT, EXOTIC TEAM MX, AGPL-3.0.
    Claude-Session: https://claude.ai/code/session_01LzVZu2WJo4GbRZpdPB4koe
    [asa_gaivota_contorno.dxf, asa_gaivota_referencia.dxf]
2026-11-11 Aba da asa de gaivota no estilo do Fujitora
    Subida a 45° desde o corpo, curva de raio 16 mm, trecho horizontal
    longo e ponta em semicírculo (6,1 mm, 7 mm na raiz). Sensores nas
    mesmas posições, então as contagens não mudam. A versão anterior
    fica disponível em ESTILO = 'suave'. Simulador regenerado e testado.
    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
    [asa_gaivota_contorno.dxf, asa_gaivota_referencia.dxf]
2026-11-11 Aba com ponta da v3 e início mais geométrico
    Largura constante de 6,1 mm, subida reta a 45°, dobra de raio 6 mm e
    concordâncias de 2 mm com o corpo. A ponta é cópia da ponta da aba da
    v3, transladada para o QRE externo. Sensores nas mesmas posições.
    Simulador regenerado e testado.
    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
    [asa_gaivota_contorno.dxf, asa_gaivota_referencia.dxf]
2026-11-11 Exemplos de aba mínima (mais baixa e mais curta)
    contorno.py aceita --externo X Y e --nome para gerar variantes sem mexer
    na versão adotada. Exemplos: externo em (81,5; 16), mínimo com asa, e
    (81,5; 14), aba reta. Margens conferidas em passo 0,25 mm e registradas
    no README do estudo 08.
    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
    [exemplo_minimo_asa_contorno.dxf, exemplo_minimo_asa_referencia.dxf, exemplo_minimo_reta_contorno.dxf, exemplo_minimo_reta_referencia.dxf]
2026-11-11 Adota a aba mínima com asa: QRE externos em (±81,5; 16)
    Aba 4 mm mais baixa e 1 mm mais estreita no total (172,2 × 58,6 mm),
    mesma silhueta. Verificação refeita em passo 0,25 mm: 33/33 e 35/35 nas
    pistas do TRIF em todos os cenários (margem mínima 1,1 mm com ±5 mm).
    Simulador, teste automático, README e CLAUDE.md atualizados; a primeira
    versão fica em saida/primeira_versao*.
    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
    [asa_gaivota_contorno.dxf, asa_gaivota_referencia.dxf, primeira_versao_contorno.dxf, primeira_versao_referencia.dxf]
2026-11-11 Proposta de pinos para os 4 QRE de marca
    E2/D2 (externos) em A5/A6, mantendo o mapa do EVA-RT 1.2.2; E1/D1
    (internos) em D8/D9, os únicos pinos livres da v3, com leitura digital.
    A emulação do Marks.ino mostra que o par externo para só na chegada nas
    pistas do TRIF; o interno gera paradas falsas no modelo de 2025.
    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
2026-11-11 PINOS: recomendação para o pedido (47 kΩ + 10 nF DNP nos internos)
    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
2026-11-11 Gera o projeto EasyEDA da v4 com a asa de gaivota
    A partir da v3: contorno novo, componentes e trilhas das abas levados
    para os QRE externos, trilhas novas do corpo até a aba, QRE internos
    S3/S4 (girados 45°) com 220 Ω, 47 kΩ e 10 nF DNP, redes MARK_L2_D8 e
    MARK_R2_D9 nos pinos 12/13 do ATmega (esquemático e PCB). Faltam no
    EasyEDA: refazer o cobre, rotear essas duas redes até o ATmega e o DRC.
    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
    [ProPrj_RUSH - SATURN - v4_asa_gaivota_2026-11-11.epro]
2026-11-11 v4: corrige pinos dos 47 kΩ internos e rótulos do S1/S2; verificações
    - R24/R26: números de pino da PCB batiam ao contrário do esquemático
    (sinal no pino 1); girados 180°, redes iguais às do R5/R8.
    - Rótulos de serigrafia do S1/S2 ficavam fora da aba; agora sob os pads.
    - Texto do esquemático tirado de cima do símbolo do S3.
    - Novos scripts: netlist_sch.py (esquemático × PCB pino a pino, zero
    divergências na v3 e na v4), verifica_placa.py (folgas, borda, furos,
    pontas soltas, rótulos e sobreposição, comparando com a v3) e
    pour_sim.py (simula o cobre de GND).
    Claude-Session: https://claude.ai/code/session_01LzV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
    [ProPrj_RUSH - SATURN - v4_asa_gaivota_2026-11-11.epro]
2026-11-11 Modelo 3D simplificado da v4 com barra V1 e varetas
    gerar_modelo.py monta a placa v4 (contorno e componentes do .epro), rodas,
    gearboxes, carcaça da ventoinha, bateria, presilhas, varetas e a barra V1
    (contorno do Gerber) a 63,14 mm entre furos; exporta robo_v4.glb (cores) e
    robo_v4.stl. visualizador.html é um visualizador three.js autocontido.
    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
    [robo_v4.stl]
2026-11-12 v4: roteia MARK_L2_D8 (E1 → pino 12) automaticamente
    Roteador A* em grade (duas faces, vias 0,6/0,3, trilha 0,2 mm) com
    esticamento em geometria exata e custo extra perto de pads de GND;
    vias de costura para manter o cobre de GND inteiro. MARK_R2_D9 não tem
    caminho sem alterar o roteamento da v3 junto ao ATmega (PINOS.md).
    Checagem do modelo de pad OVAL corrigida (oblongo, não elipse).
    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
    [ProPrj_RUSH - SATURN - v4_asa_gaivota_2026-11-11.epro]
2026-11-12 v4: C19 (10 nF do E1) passa a ser montado
    Filtro RC (~0,5 ms) com o 47k na trilha longa até o pino 12; posição e
    roteamento já existentes (face de baixo, ao lado do R24). C20 segue DNP.
    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
    [ProPrj_RUSH - SATURN - v4_asa_gaivota_2026-11-11.epro]
2026-11-12 Figura da rede LEDA_D2 na v4
    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
2026-11-12 Figura da rede PWMC_D10 na v4
    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
2026-11-12 v4 de 12/11: correções sobre o arquivo do Erick e tudo em 45°
    - religa E1 (S3.4 → R24) e o anodo do D1 (S4.1 → R25), soltos ao mover os
    resistores; liga o C20
    - desvia o MARK_R2_D9 da traseira (isolava o GND do reset SW1)
    - chanfra em 45° os cantos retos e converte trechos em ângulo quebrado
    - rótulos do S1/S2/S4 dentro da placa
    Verificado: esquemático = PCB, redes inteiras, folgas/borda/furos, GND
    simulado, nenhum canto <= 90° e nenhum trecho fora de 0/45/90°.
    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
    [ProPrj_RUSH - SATURN - v4_asa_gaivota_2026-11-12.epro, entrada_erick_2026-11-12.epro]
2026-11-13 v7: corrige erros do DRC, costura o GND da placa e passa os pads dos motores para furo de 1 mm
    - MARK_L2_D8: trilhas de 0,2 mm passam a 0,25 mm; liga R24 ao C19; troca de face no pino 12 movida para abrir o GND dos pads de gravação
    - MARK_R2_D9: sai de cima do pad do rasgo traseiro (e311) e passa acima dele, a 45°
    - 37 vias de GND nas ilhas que o EasyEDA apagaria (simulação com folga de 0,35 mm)
    - footprint MOTOR_1020_2P: furo de 0,9 para 1,0 mm (M1, M2 e M3)
    - check.py passa a considerar pads soltos
    Baseado no EVA-RT (EXOTIC TEAM MX, AGPL-3.0).
    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
    [ProPrj_RUSH - SATURN - v7_2026-11-13_corrigido.epro, entrada_erick_v7_2026-11-13.epro]
2026-11-13 Guarda o arquivo do Erick após o DRC e registra a análise dos PTH sob a placa de sucção
    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
    [entrada_erick_v8_2026-11-13.epro]
2026-11-13 Lista de capacitores e resistores da v4 com C1/C2 em eletrolítico SMD
    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
2026-11-14 Lista: substitutos aceitos para R16, R14/R15, R2 e C3
    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
2026-11-14 Lista: R11 de 5% aceito
    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
2026-11-14 v8: C1/C2 em eletrolítico SMD (fora da placa de sucção) e C20 montado
    - vias VBAT de 1,6/1,0 mm no lugar dos pads + dos radiais (passagem de face mantida)
    - via de GND junto ao pad − de cada capacitor (os pads PTH antigos ligavam o GND das duas faces)
    - C1 a 270°, C2 a 45°; nenhuma trilha existente alterada
    - C20: DNP = não no esquemático e na PCB
    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
    [ProPrj_RUSH - SATURN - v8_2026-11-14.epro, entrada_erick_v8f1_2026-11-14.epro]
2026-11-14 v8.1: alinhamentos, via VBAT do C2, QRE renomeados e nada travado
    - C5/C1 no mesmo x, C3/C4 simétricos ao C5, C1/C2 na mesma altura, LED1/R1 sobem com o grupo
    - trilhas presas aos pads movidos voltam ao centro dos pads (45°); VBAT do C3 afastada do GND
    - via VBAT 1,6/1,0 do C2 restaurada; 5 vias de costura de GND
    - QRE: S1/S2 na asa esquerda, S3/S4 na direita (esquemático e PCB)
    - todos os objetos destravados; scripts deixam de gravar vias travadas
    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
    [ProPrj_RUSH - SATURN - v81_2026-11-14_corrigido.epro, entrada_erick_v81_2026-11-14.epro]
2026-11-14 v8.2: GND do J3 e do R3 religados, rótulos dos QRE e análise de corrente
    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
    [ProPrj_RUSH - SATURN - v82_2026-11-14_corrigido.epro, entrada_erick_v82_2026-11-14.epro]
2026-11-14 v8.3: segunda via de VBAT no C2 e R14/R15 de 910 Ω (ITRIP ≈ 4,9 A)
    Comparação com o EVA-RT e o HyperLine em PINOS.md; lista de compra, BOM,
    gen.py e docs atualizados. Baseado no EVA-RT (EXOTIC TEAM MX, AGPL-3.0).
    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
    [BOM_seguidor_base.csv, ProPrj_RUSH - SATURN - v83_2026-11-14.epro]
